delandtj/stm32-engraver/Hardware/graver-controller/output/pcb/mcu.png

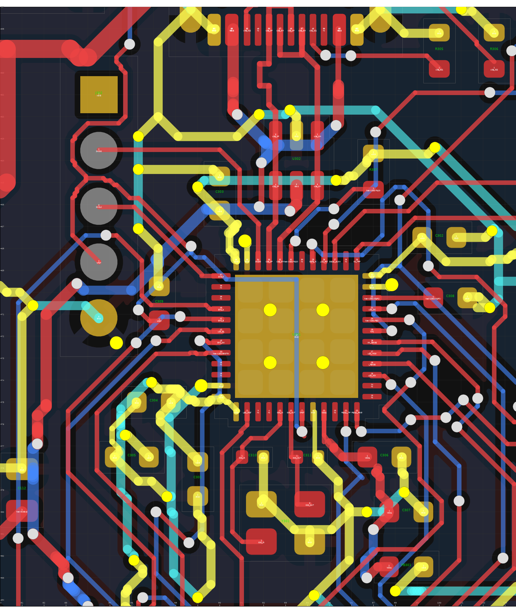
Hardware/graver-controller/output/pcb/mcu.png
