delandtj/stm32-engraver/docs/mosfet-module-eg27324-m3004d.jpg

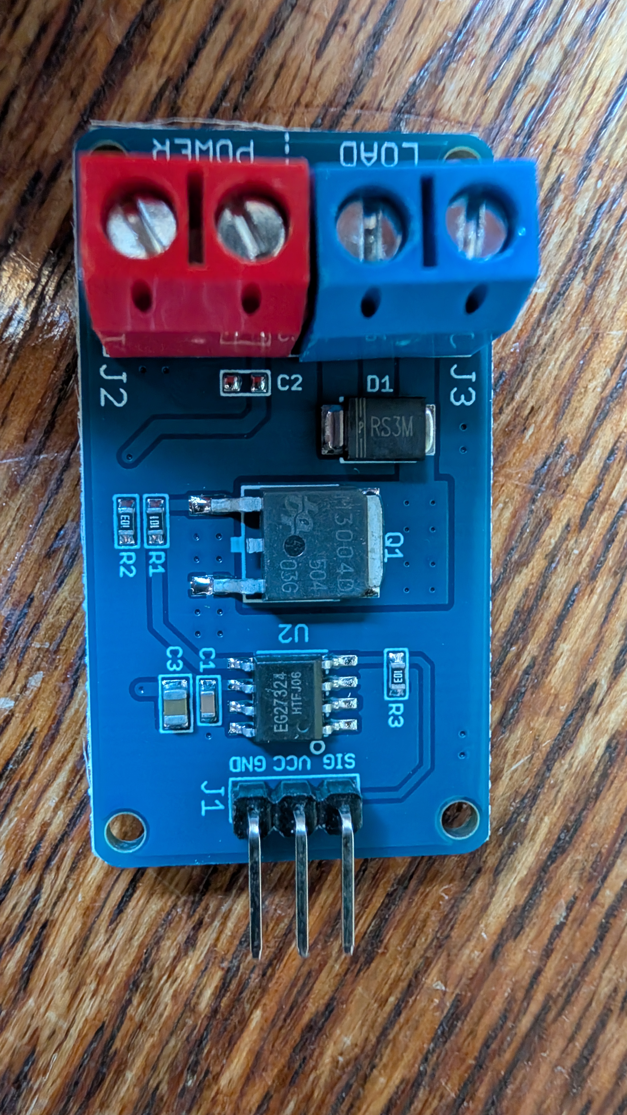
docs/mosfet-module-eg27324-m3004d.jpg
