delandtj/stm32-engraver/docs/HANDOFF.md

# Handoff: graver controller board

Last updated 2026-10-19. Read this first in a new session; it says what
exists, what is decided, how to work on it and what comes next.

## Start here

**Session 2026-10-16 .. 2026-10-19: first boards on the bench, rev 2, box.**

- Bring-up, board 1 (F101 bridged with a wire after it blew - no fuse, so
  bench PSU with a current limit only, never the brick):
  - Flashed over SWD (`probe-rs run --chip STM32F411CEUx`; with an ESP32
    also plugged in add `--probe 0483:3748`; `cargo run` needs
    `--bin graver-controller`).
  - Verified: display (offset 0, inverted), encoder (4 counts per detent),
    encoder push, settings journal, heartbeat LED D301 (~5 Hz).
  - The picture is now rotated 180 deg for the box mount (header end down).
  - Not yet done on any board: 24 V on VIN, VIN reading, pedal, NTC,
    firing, bootloader jump. See docs/bringup-checklist.md.
- F101 lesson: the rev 1 fuse (0437001.WR) is fast-acting, despite the old
  "1A slow" label. Hot-plugging 24 V into C101 blows it. Rev 1 rework: a
  1206 PTC, Littelfuse 1206L035/30WR (C2153989). Until then, ramp the PSU
  up from 0 V.
- Rev 1 hand soldering: the THT GND pads are solid to the In1 plane (no
  thermal relief) and hard to solder. Use a big chisel tip at 380-400 C
  lead-free, and preheat the board.
- Rev 1 as ordered is tag `rev1-ordered` (e8bf91c). `master` is rev 2:
  thermal relief on both inner planes (pcbkit now passes KRT
  `--thermal-relief` by default) and the TPS26602 input eFuse (ADR 0007).
  Fab set regenerated, DRC/parity 0.
- Enclosure: ADR 0006, `Box/`. A FreeCAD wedge (tray plus cover), the
  display sliding into rails with a snap latch, the encoder on two nuts,
  GX12-4 handpiece at the front, GX12-3 pedal at the rear, M3 heat-set
  inserts, support-free at 60 deg. Rebuild with `Box/build_enclosure.py`
  from the Params sheet. Still to measure: the real GX12 hole, nut and
  depth.
- Pedal socket: GX12-3 (never 4-pin), the pedal's own plug replaced.
- PC USB: if the ST-LINK vanishes, the xhci controller 0000:7b:00.0 may be
  wedged. Unbind and bind it via /sys/bus/pci/drivers/xhci_hcd.

Older notes follow.

**2026-10-09, ADR 0005 (Accepted): the board is now 4-layer, 85 x 60 mm,
built with pcbkit** on branch `adr-0005-compact-4layer`. kicad-cli DRC
after a zone refill: 0 errors, 0 unconnected, 0 parity, 0 warnings; USB
pair 0.25/0.15 with 0.000 mm skew and no vias; In1 solid GND, In2 solid
+3V3; a 25 x 20 mm reserve for the ADR 0004 boost stage at the front left.
Fab set in `Hardware/graver-controller/fab/`. Everything below this
paragraph that mentions `tools/pcb/`, 95 x 70 or 2 layers describes the
previous board (tag `pcb-pre-pcbkit`, also `v0.2`). The new pipeline is
`Hardware/graver-controller/tools/pcb5/` on `../pcbkit`:

    tools/pcb5/build.sh board    # netlist -> mkboard -> outline -> setrules -> place.py
    python3 tools/pcb5/handroute.py   # USB pair, crystal, QFN fan-out (group 'hand')
    tools/pcb5/build.sh route    # krt-route (about a minute), viaout, postroute.py
    python3 tools/pcb5/widen.py; python3 tools/pcb5/joins.py   # widths, the last opens
    python3 tools/pcb5/floors.py; pcbkit krt-reroute --keep LCD_SCK ENC_SW LCD_BL LCD_RST "Net-(R210-Pad1)" PEDAL_TIP   # ADR 0003 width floors
    tools/pcb5/build.sh finish   # gndpour, DRC, prune, silk, connlabels, refill
    tools/pcb5/build.sh check    # DRC + check.py (ADR 0005 acceptance) + renders
    tools/pcb5/build.sh fab      # jlcfab -> fab/, then cplcheck.py against EasyEDA

The committed .kicad_pcb is the artifact; the router is not deterministic,
so do not regenerate unless placement changes. joins.py holds explicit
coordinates for the five pairs KRT left open (NRST, VDDA, U102 input,
PEDAL_TIP, a GND island); after a re-route they may no longer apply.
Lessons: KRT cannot escape the QFN48 or attach to the USB-C pads by itself
(hence handroute.py), `krt-reroute` without `--keep` rips neighbours, and
every pcbnew save goes to scratch with only the .kicad_pcb copied back.
Open for order day: confirm the 4-layer price with the quote. The CPL
rotations are verified against the EasyEDA footprints (tools/pcb5/cplcheck.py,
27 of 27 parts agree), which is ADR 0003 step 8's rotation review. Width floors are ADR 0003's (0.5 / 0.3 mm), with 0.2 mm only at the
0.5 mm pitch pads as ADR 0003 says (ADR 0005 "As built").

**The board is finished and tagged `v0.2`** (commit 9645970, signed).
95 x 70 mm, 2-layer: 0 DRC errors, 0 schematic parity, 0 unconnected, all
eight per-net width floors PASS. Nothing more is needed on the copper.

**But it has never been near real hardware.** The firmware has never run on
a board, the 24 V punch test is unanswered and coil inductance is unmeasured.
v0.2 passes every check that can be run on a file; it is not a board known to
work. Keep that distinction - "0 DRC errors" is not "it works", and this
document said so too quietly once already.

**What changed on 2026-10-01 (ADR 0003 Decision 9):** every board connector
except USB-C became a row of plated holes for a soldered wire loom, the
rotary encoder moved off the board into the cover plate, and the board shrank
from 110 x 70 to 95 x 70. Jan's reasoning: sourcing the mating halves was the
problem, soldering is not. It also deleted the four unverified THT footprints
in one go, which was the largest open layout risk in the project, and brought
the long side under JLC's 100 x 100 price band.

**The single next piece of work** is the export set, ADR 0003 step 8 - Gerber,
drill, BOM, CPL, STEP, assembly PDF, test sheet. None of it exists; nothing in
`tools/` produces it. Everything else below is a decision rather than a task.

**Two decisions are blocking**, both in "Open items": whether JLC's THT service
still earns its fee, and a manufacturer STEP for J301 (without it the enclosure
cannot be drawn around the USB opening, because that part is invisible in 3D).
The pedal is settled (2026-10-13): a 5-pin TIG welding foot pedal, see
"Pedal" under Open items; one sample must be measured before ordering the batch.

## What this is

A new controller for the ITS-LZ-1335 solenoid graver in this repo. Batch of
8-10 boxes for a class (adults), each box = 24 V brick + this PCB + 1.3"
ST7789 display + one handpiece + TIG foot pedal. PCB fully assembled by
JLCPCB, no soldering by the builders, under EUR 150 per box, enclosure to be
3D printed (Creality K2 Max). Since 2026-10-01 Jan solders five wire looms
per box when he assembles them; the class still receives finished boxes.

Upstream project: Savage-Sabrina/DIY_SolenoidGraver (Arduino Nano board);
Jan's fork of it is a separate repo. Since 2026-09-17 this controller lives in
its own repository, github.com/delandtj/stm32-engraver (`origin`), split out
with full history. Branch `master`.

## Where things are

| What | Path |
|---|---|
| Spec / decisions (Accepted) | `docs/adr/0001-graver-controller-board.md` |
| KiCad 10 project | `Hardware/graver-controller/` (root + power/driver/mcu/io sheets) |
| PCB placement script (board is generated) | `Hardware/graver-controller/tools/pcb/` (see its README) |
| Schematic checks; retired generator | `Hardware/graver-controller/tools/` (see its README) |
| Rev 0.1 reference sheets (history) | `Hardware/graver-controller/tools/ref/` |
| Part choices, LCSC numbers, datasheet gotchas | `Hardware/graver-controller/docs/parts-power.md`, `parts-mcu.md` |
| Net-by-net capture list | `Hardware/graver-controller/docs/capture-netlist.md` |
| Firmware spec (Accepted) | `docs/adr/0002-firmware.md` |
| PCB layout + production spec (Accepted) | `docs/adr/0003-pcb-layout-and-production.md` |
| Firmware (Rust, embassy-stm32) | `Firmware/graver-controller/` (see its README) |
| Bench rig wiring | `docs/bench-rig.md` |
| Old Arduino design (context only) | `Schematic/`, `Arduino Code/`, `README.md` |

## State of the design

Schematic rev 0.1 is complete, drawn properly (wires, decoupling at pins,
signal flow), ERC 0 violations, every real part has value, footprint and LCSC
number. Since 2026-09-17 it is edited in eeschema (generator retired); U101
uses the HSOP-8 footprint without the library's 0.2 mm thermal vias.

2026-10-01 schematic edits (ADR 0003 Decision 9), ERC 0 and netlist diffed
pad-by-pad against the previous export - every difference was an auto-
generated net *name* following its anchor pin, no connectivity changed:

| ref | was | is now |
|---|---|---|
| J101 | `Connector:Barrel_Jack_Switch` | `Conn_01x02`, pads GND / +24V |
| J201 | Screw terminal symbol, Phoenix footprint | same symbol, `PinHeader_1x04` |
| J401 | `Conn_01x07`, JST XH footprint | same symbol, `PinHeader_1x07` |
| J402 | `Connector_Audio:AudioJack3_SwitchTR` | `Conn_01x04`, pads T / RN / R / S |
| J403 | was `SW401`, `RotaryEncoder_Switch_MP` | `Conn_01x04`, pads A / GND / B / SW |

The five pad rows carry **no LCSC and no MPN property**. They are holes, not
parts; an empty field is dropped when place.py copies fields onto footprints,
which then reads as a schematic-parity mismatch, so the properties are gone
from the symbols rather than blanked. Three orphaned no-connect flags (the
old jack's switch pole, the jack's TN pin, the encoder's MP lugs) were
removed with them.

PCB: re-placed, re-routed and **electrically complete** on 95 x 70 mm as of
2026-10-01. State: **0 DRC errors, 0 schematic parity, 0 unconnected, 11
warnings** (1 lib_footprint_mismatch on J301, 4 track_dangling, 6
via_dangling), 126 router vias plus 10 hand vias, all placement checks and
ADR criteria PASS, all eight per-net width floors PASS, GND island and
sense-ground trees PASS, one allowed USB crossing and no disallowed ones.

The autorouter left 3 pairs open and they were closed by hand with
`tools/pcb/close_open.py` (see below), then captured into
`tools/pcb/manual.json` with `place.py --export-manual`: 38 items, 33 on
+5V and 5 on GND.

Drill table, counted off the board 2026-10-01 (needed for the ADR 0003
step 8 export, and worth a glance before ordering):

| drill | count | what |
|---|---|---|
| 0.30 mm | 233 | vias |
| 0.60 mm | 4 | J301 shell tabs |
| 1.00 mm | 24 | the four pad rows (19) + J302 SWD (5) |
| 1.20 mm | 2 | C101 bulk cap |
| 1.75 mm | 2 | J101 power in |
| 0.65 mm NPTH | 2 | J301 locating pegs |
| 3.20 mm NPTH | 4 | M3 mounting holes |

271 holes, 5 plated sizes, 2 non-plated. Ordinary for a 2-layer board with
a stitched pour - no slots, no castellations, no half-holes, and JLC does
not surcharge for the number of distinct sizes. Two notes:

- **0.30 mm is exactly JLC's minimum for standard plated holes**, so the
  vias sit on the floor with no margin. That is deliberate (ADR 0003
  Decision 5: "via 0.3 mm drill / 0.6 mm pad, no smaller via anywhere"),
  but it is the first thing that would bite if their cheap tier moved.
  0.4 mm drill would buy margin at the cost of fatter pads.
- **J101 is 1.75 mm, not 1.4.** Its footprint is named
  `SolderWire-1sqmm_1x02_P5.4mm_D1.4mm_OD2.7mm` and the `D1.4mm` is the
  wire it suits, not the hole; the file says `(drill 1.75)`. The ADR, the
  parts table and this document all repeated the 1.4 mm misreading until
  2026-10-01. Nothing on the board changed - 1.75 mm is roomier for an
  18 AWG lead and the annular ring is still 0.48 mm.

`graver-controller.kicad_pcb` is GENERATED by the pipeline in `Hardware/graver-controller/tools/pcb/` (README there is the
manual):

    python3 tools/pcb/place.py --copper --silk --route   # ~45 min, --route is the slow part
    python3 tools/pcb/place.py --copper --silk           # ~1 min, no autorouting
    tools/pcb/render.sh                                  # PNGs in output/pcb/
    tools/pcb/routability.sh                             # placement test on a scratch copy

- place.py: board from the netlist (117 parts linked by UUID, parity 0),
  outline, placement as data tables, courtyard / keepout / ADR-distance
  checks with a PASS/FAIL table.
- copper.py: the critical copper, scripted and locked: GND pour and
  stitching, M3 and crystal keepouts, QFN escape fan, decoupling, crystal,
  VDDA, USB pair (37.9/37.9 mm, skew 0, bands on B.Cu), VIN and flyback
  loop at 1.0 mm, buck loops, shunt Kelvin, sense-side ground as one tie
  (checked tree), GATE_IN, I_SENSE, VIN_SENSE, +3V3 and +5V trunks. Prints
  a budgets table.
- silk.py: references off the pads, rear-edge labels, pin-1 marks.
- autoroute.py: KiCadRoutingTools on a SCRATCH COPY, strict, three
  attempts, best imported into the group 'autorouted' after kicad-cli
  grading against the committed .kicad_pro. The router is not
  deterministic: the same input gives 4-17 open pairs between runs.
- manual.py: `place.py --export-manual` keeps tracks drawn by hand in
  pcbnew across regeneration (tools/pcb/manual.json).

### Closing the last pairs: close_open.py (2026-10-01)

`tools/pcb/close_pairs.py` is **stale and must not be trusted**. It is not a
general pair-closer: it was written against the old board's geometry and names
specific tracks and corridors ("the +3V3 B.Cu track at (41.55, 47.8)",
"ENC_A's run across the corridor is the wall between PB2's escape and R303").
On the 95 x 70 board those do not exist and a `--dry` run ends in
`FAIL: nothing ripped for ENC_A`.

`tools/pcb/close_open.py` replaces it for this board. It is a thin driver over
the GOOD half of close_pairs - the two-layer clearance grid, the Dijkstra, the
octilinear simplifier, the `manual` grouping - with targets found by name or
by point instead of by coordinate table:

    python3 tools/pcb/close_open.py          # draw, refill, save, DRC
    python3 tools/pcb/close_open.py --dry    # report only, write nothing

It closed all three: +5V D105.1 -> C201.1 (68.28 mm, 10 vias, 0.30 mm) and
two short GND stubs. Three things learned doing it, all now enforced in the
script:

1. **The USB pair walls the board in half.** With the pair's B.Cu shadow
   respected there is NO +5V path between the power block and the gate
   driver. A search allowed to ignore the shadow came back crossing the run
   TWICE at a shallow angle, and `autoroute.usb_reference_check` refused it -
   correctly. The answer is the same one the old board used: ONE short
   perpendicular crossing at a site chosen for clearance (1.56 mm of B.Cu at
   90 degrees, 0.60 mm off the nearest pair track), whitelisted in
   `autoroute.USB_CROSSING_OK`. That entry moved from the old board's
   (36.45, 21.35) to **(31.62, 16.77)**.
2. **The script must draw ALL targets every run.** `group_manual` replaces
   the whole `manual` group with whatever the current run drew, so a run that
   skipped a target as "already joined" deleted the copper that joined it -
   two runs in a row ping-pong between the +5V route and the GND stubs. Hence
   `strip_manual()`: start from the autorouted baseline each time and redraw
   everything. The script owns that group.
3. **A bridge or hand route on a Power-class net must carry that net's
   `.kicad_dru` floor**, not `W_SIG`. See the copper.py note - one undersized
   segment makes autoroute's import gate refuse the entire route.

The router remains nondeterministic (3-10 open pairs between runs), so the
committed board file is still the artifact: do not regenerate unless
placement or scripted copper changes. If you do regenerate, `manual.py`
restores the 38 hand-drawn items from manual.json, and anything still open
after that is `close_open.py`'s job again.

The old warning that the mop-up re-lays 0.3 mm nets at 0.2 mm is stale -
`autoroute.py` now runs one pass per width class at that class's floor and
the import gate drops any net carrying undersized copper. All eight floors
PASS on the committed board.

The old "right third of the board is empty" complaint is what the shrink to
95 x 70 answered: the connectors and the encoder were reserving that space,
not the electronics, which fit inside 84.5 x 64.0 mm. Design rules and net
classes live in the .kicad_pro (SaveBoard rewrites it, the scripts restore
it).

3D: only J301 (HRO USB-C) still lacks a model in any KiCad library, and it
needs a manufacturer STEP in a project 3d/ folder before the enclosure
export. SW401 and J402 left this list with the parts themselves; the cover
plate now carries the encoder and the box sockets, so the enclosure model
needs their geometry instead, plus a loom exit for each pad row.

Pad rows all read left to right in ascending pad order, pad 1 leftmost seen
from the front - the old "J201 is rotated 180, so it reverses" rule is gone.
J201: 1 VIN, 2 COIL_NEG, 3 NTC, 4 GND.

Key facts (details in the ADR):

- Coil: both 1335s measure 141 ohm = the 24 V / ~4 W variant. So: 24 V brick
  standard, electronics rated 18-36 V, DC jack rated 30 V (bricks 18-30 V).
  Coil current 0.17-0.26 A; driver scoped to coils >= ~100 ohm.
- MCU: STM32F411CEU6 on board (same chip as the WeAct Blackpill, used for
  firmware bring-up). USB-C for DFU updates, SWD header for development,
  PA10 pull-up so the ROM bootloader picks USB. No LSE crystal.
- Strike: TIM1 one-pulse on PA8 -> UCC27517 gate driver -> IRLR3410 low
  side. 1 ohm shunt -> TLV9062: one half is a x11 amplifier to PA6, the
  other a comparator (~0.77 A trip) into TIM1_BKIN (PB12).
- Flyback: SS110 + SMBJ24A fast decay by default; SI2309 P-FET across the
  TVS gives plain-diode slow decay when PB14 (DECAY_SLOW) is high.
- Power: fuse, DMP6023LE reverse-polarity P-FET, SMBJ36A, 470 uF, LM5164
  buck set to 5.28 V (EN starts ~14 V, BST cap 2.2 nF), two SS14 OR the buck
  and USB VBUS into +5V, AP2112K-3.3 LDO. USB alone runs the logic.
- UI: 1.3" ST7789 240x240 3.3 V module (no CS, SPI mode 3, backlight PWM
  from PB6 through 100 R). It sits in the cover plate on a 7-way loom
  soldered into the J401 pad row: 1 GND, 2 +3V3, 3 SCL, 4 SDA, 5 RES, 6 DC,
  7 BLK, pad 1 leftmost. The encoder (30 detents / 15 pulses, TIM3 encoder
  mode, push on PB7) also mounts in the cover plate and takes 4 wires into
  J403: 1 ENC_A, 2 GND, 3 ENC_B, 4 ENC_SW. The EC11's encoder common and
  switch common are the same net, so they join at the encoder body - run 5
  wires if that bridge is unwanted. The 10k pull-ups R402-R404 and the 10 nF
  debounce C401-C403 stay on the board at the MCU, so the A/B lines leave the
  board at 10k impedance: keep that loom away from the handpiece cable, and
  if it miscounts on the bench drop R402-R404 to 2.2k. Any EC11 now works -
  it is off the JLC BOM, so no footprint has to match it.
- Pedal: no jack on the board. J402 is a 4-pad row - 1 TIP, 2 RN, 3 RING,
  4 SLV - and the socket lives in the box. The circuit is unchanged: ring =
  3V3 through 1k, tip = wiper to PA1, ring sense on PA2, PESD5V0S2BT on tip
  and ring. RN (pad 2) is GND and only matters for a TRS socket with a
  ring-normal contact. The chosen 5-pin TIG pedal does not use it - see
  "Pedal" under Open items for the wiring.
- Handpiece: 4-pin GX12 aviation socket on the box (pre-wired pigtail), its
  four wires soldered into the J201 pad row: 1 VIN, 2 COIL_NEG, 3 NTC
  (optional), 4 GND, pad 1 leftmost. The 5.08 mm terminal and screw plug are
  gone.
- Power in: J101, two 1.75 mm holes, pad 1 GND and pad 2 +24V, brick leads
  soldered straight in. With no barrel jack the DC-005's 30 V ceiling no
  longer applies, so the 18-36 V electronics rating is the only limit left.
  The pair wants a strain-relief anchor so the solder is not the mechanical
  joint.
  Input protection differs per revision. Rev 1 (the 12 built boards): F101
  fuse + Q101 reverse-polarity PMOS; F101 gets the 1206L035/30WR PTC as a
  rework (see "Brick sizing"). Rev 2 (branch board-rev2, ADR 0007): U103
  TPS26602 eFuse instead of F101/Q101/D101/R101 - reverse polarity, 1.0 A
  limit with auto-retry, 42 ms soft start, UVLO 14.9 V, 38 V clamp. Its RTN
  net is a separate copper island and must never be tied to GND. Layout:
  tools/pcb5/efuse.py.
- Pin map: in the ADR, verified against the datasheet.

### Brick sizing (worked out 2026-10-01)

**Buy 24 V, 2 A (48 W).** The box needs far less than that; the headroom is
for sag, not for amps.

| load at 24 V | current |
|---|---|
| coil while the FET is on, 141 ohm (ADR 0001) | 170 mA |
| logic, realistic: MCU + display + backlight | ~35 mA |
| logic, the buck's full design budget (0.5 A at 5 V, ~90%) | ~115 mA |
| **worst-case peak, coil and logic together** | **~290 mA** |
| average at the 35 % duty cap | ~95 mA |

About 7 W worst case, and the coil only draws its 170 mA during the pulse.
The on-board fuse is the board's own ceiling: since 2026-10-17 a 1206 PTC
(Littelfuse 1206L035/30WR, 0.35 A hold, 0.75 A trip). The first 12 boards
were built with 0437001.WR, which is a FAST 1 A fuse despite the old "1A
slow" label, and it blows when 24 V is hot-plugged into the 470 uF (board 1
did). Swap F101 for the PTC on those boards; until then ramp the PSU up
from 0 V instead of connecting a live supply.

1 A (24 W) would genuinely do it with 3x margin. 2 A costs about the same and
buys three things:

1. Headroom for the low-resistance-coil experiment (a 36 ohm coil on 24 V
   pulls 0.67 A - see the 12 V note below).
2. Inrush into the 470 uF bulk cap at power-on without the brick hiccuping.
3. **No sag during the strike**, which is the one that affects how it feels.

Point 3 is the real reason. A weak brick droops under the pulse, and droop
weakens the hit directly: less voltage across the coil means slower current
rise, which IS the strike. The firmware is watching too - it warns below
18 V (VIN_WARN_MV) and refuses to fire below 15 V (VIN_MIN_FIRE_MV) - so a
weedy supply would both soften the strikes and nag on screen. The 470 uF cap
buffers the fast edge but cannot carry a long pulse: at 170 mA for 15 ms it
would sag 5.4 V on its own, so the brick supplies the bulk of a long strike.
Stiffness counts more than raw amps.

Two limits:

- **Do not exceed 36 V.** That is the electronics rating, and it is now the
  only one - the old 30 V ceiling belonged to the DC jack, which is gone.
- **A bigger brick does not make it hit harder.** Coil resistance sets the
  current: 24 V into 141 ohm is 170 mA whether the supply can do 1 A or 10 A.
  Extra capacity only stops it sagging. The levers for more punch are higher
  voltage or a lower-resistance coil, not a bigger brick.

### 12 V coils: what it would take (worked out 2026-10-01, nothing changed)

Two different questions, often confused. Neither has been acted on.

**(a) Running the BOARD from a 12 V brick.** Three blockers, one of them
hardware:

1. The buck never starts. The LM5164 EN/UVLO divider is 1M / 120k against a
   1.5 V threshold, so it enables at about 14 V. At 12 V there is no 5 V
   rail and the board is dead except on USB. Fix: R106 120k -> ~180k, which
   moves the threshold to ~10 V. One 0402.
2. `VIN_MIN_FIRE_MV = 15_000` refuses to fire. Note the firmware ALREADY has
   `#[cfg(feature = "low-vin")]` setting it to 10_000, written for a 12 V
   bench supply and marked "Never for the production board". The mechanism
   exists; it needs promoting to a supported mode. `VIN_WARN_MV = 18_000`
   needs rethinking with it.
3. The I_SENSE readout saturates. The x11 amp (R210 10k / R211 1k) hits the
   rail at 0.3 A. Fix: R210 -> 6.8k. The overcurrent trip is unaffected - it
   reads the raw shunt.

Nothing else cares: fuse, DMP6023LE (60 V), SMBJ36A, 470 uF 63 V, the LM5164
itself (100 V, works from 6 V), IRLR3410 (100 V), UCC27517 (fed from 5 V),
the LDO. All overrated at 24 V and absurdly so at 12 V.

**Supporting EITHER supply is the same work, not more.** Set the enable
threshold once at ~10 V and both bricks start the buck; set the sense gain
once at ~x8 and both coil currents fit. The firmware already has the piece
that makes it work - supply compensation holds volt-seconds constant
(`t = t * V_NOMINAL_MV / vin`, V_NOMINAL_MV = 24_000), so at 12 V it doubles
the on-time for the same strength setting. Cost: two resistor values plus
making two constants runtime instead of compile-time. The only compromise is
that at 12 V the doubled on-time hits T_ON_MAX and the duty cap sooner, so
the top of the strength range compresses.

**(b) Driving a 12 V COIL from the existing 24 V brick.** Electrically fine,
but the board was deliberately scoped against it. A 12 V coil of the same
~4 W is ~36 ohm, so on 24 V it pulls 0.67 A, and parts-power.md already
analysed this exact case: it collides with the 0.8 A trip (0.67 A is 84 % of
threshold - expect nuisance trips on a comparator whose ~3 mV hysteresis is
a known weakness), the 1 ohm 1206 shunt (0.45 W while on against a 0.25 W
rating; 0.16 W average at 35 % duty), and the I_SENSE ceiling. That document
offers the fix if low-R coils are ever wanted: "a 0.33 ohm 1 W 2512 shunt
with gain about 30, a 2 A slow fuse, and a trip threshold that scales with
the coil". ADR 0001's "coils >= ~100 ohm" scope is that sentence being
declined.

Coil thermals are the real limit there, not the board: 24 V into 36 ohm is
16 W while on, against a ~4 W part, with nothing but duty cycle protecting
it. At the 35 % cap that averages 5.6 W, over rating - it would want the cap
nearer 25 % and the NTC fitted so the 70 C cutout can see the coil.

**Why it is still interesting**: deliberately overdriving a solenoid is
standard practice and good for punch - more volts across less inductance
makes current rise faster, and rise rate IS the strike. It is the cheapest
way to find out what harder drive feels like without building a boost rail.

**But do not spend this margin yet.** ADR 0001's biggest open question is
whether 24 V has enough punch in the first place, and that bench test has
not been run. Going lower before answering it spends headroom that may turn
out to be needed. Also note coil inductance is still unmeasured (open item
2), and until it is, neither force nor heating is predictable for any of
this - L/R decides whether a 3 ms pulse reaches 0.1 A or 0.65 A.

## State of the firmware

Written 2026-09-16, builds clean (release, clippy) for thumbv7em-none-eabihf,
NOT yet run on hardware. Tasks: analog (ADC 200 Hz), input (TIM3 encoder or
three buttons with `--features buttons`), control (modes, menu, safety),
strike (TIM1 one-pulse on PA8, break on PB12 latches), ui (ST7789 via
mipidsi, 10 Hz partial refresh), main (IWDG fed only while control
heartbeats). Settings journal in flash sector 7. Hold the encoder push at
power-up = ROM DFU bootloader. `--features bench` fires a fixed burst at
boot for scoping the strike path.

    cd Firmware/graver-controller
    cargo build --release [--features buttons,bench]
    cargo run --release            # probe-rs + defmt, needs an SWD probe
    tools/dfu.sh                   # USB DFU, no probe

Verified on hardware (board 1, F101 bridged, 2026-10-19): ST7789 with offset 0 and
colours inverted, as in ui.rs; encoder at 4 counts per detent (the class
encoders rest with A and B open at every click; firmware 9eb05f2); settings
journal survives a power cycle. Still unverified: the bootloader jump (DFU
by holding the encoder push at power-up).

## How to work on the schematic

The generator is RETIRED (ADR 0003, 2026-09-17). Edit the .kicad_sch sheets
in eeschema; `tools/build.py` refuses to run because it would overwrite them.

    cd Hardware/graver-controller
    tools/verify.sh                 # must print "Found 0 violations"; PNGs in output/verify/

- Keep the rev 0.1 drawing discipline by hand: wires not labels within a
  block, decoupling at the pins, signal flow left to right.
- Every part keeps value, footprint, LCSC and MPN fields; the JLC BOM is
  exported from them.
- Small field edits (footprint, LCSC) can be made in the file while
  eeschema is closed; verify afterwards.
- Rendering: the kicad MCP's sch_render_png is broken on this machine; use
  `kicad-cli sch export svg` + `rsvg-convert` (verify.sh does this).
- Commits are GPG-signed with a desktop pinentry; they fail when Jan is
  away from the keyboard. Commit while he is present, or unsigned only
  when he says so (2026-09-18 evening's commits are unsigned on his
  instruction). Never `git add -A`.
- Plain ASCII in files. No Claude attribution lines in commits.

## Open items (carry into the next session)

Hardware verification before layout is frozen:

1. Bench test with a 24 V brick: is 24-30 V enough punch? If not, the
   ADR's boost-rail alternative comes back. The OPEN-SMART module Jan has
   tops out at 13.5 V, so use a D4184-class module or the real FET for this.
2. Measure coil inductance (LCR meter or current-rise on a scope). Sizes the
   TVS energy and confirms the 0.5-15 ms pulse range.
3. Part number printed on the solenoids (confirms 24 V variant and duty).
4. OT3499 display: check the real pinout (7-pin, GND VCC SCL SDA RES DC
   BLK expected) and whether BLK idles high on the module.
5. VOID since 2026-10-01. This was the list of THT connector footprints to
   measure against loose parts before layout froze - DC-005 jack, WJ2EDGRC
   terminal drill, NMJ6HCD2 normalling contacts, encoder lug spacing. Every
   one of those parts left the board with ADR 0003 Decision 9, and their
   replacements are stock KiCad pad rows whose only dimension is a drill
   size. Nothing to buy, nothing to measure, no re-spin risk from this.
6. Known, accepted limits: I_SENSE saturates above ~0.3 A (trip uses the
   raw shunt), VIN_SENSE saturates during a surge clamp, comparator
   hysteresis is only ~3 mV, a shorted FET is not caught (coil just runs
   warm at 0.2 A).

Decisions still open (ADR "Open Questions"):

- **Pedal (decided 2026-10-13, one sample to measure before the batch).** A
  bought 5-pin TIG welding foot pedal (e.g. "Vector Welding remote control
  pedal, 1.5 m cable, 5 pin"): a pot plus a microswitch that closes early
  in the travel, spring return, steel housing. Spring return is the reason
  over an expression pedal, which stays where it was left. The 2+3 pin
  variant has the same five wires on two plugs; avoid it. No board change -
  the ordered board serves it as is. The box carries a GX12-3 socket at the
  rear (decided 2026-10-19, ADR 0006): the pedal's own plug is cut off and a
  GX12-3 plug fitted. Never GX12-4 - that would mate with the handpiece
  socket and put 24 V on the pedal input. Wired to J402:

  | Pedal wire | J402 pad |
  |---|---|
  | pot wiper | 1 TIP |
  | pot top, through the pedal's microswitch | 3 RING (3V3 via 1k) |
  | pot bottom | 4 SLV (GND) |
  | - | 2 RN: leave unwired (GND, TRS normal contact only) |

  Plus ~100k from TIP to SLV at the box socket. The switch in series with
  the pot top is a hardware interlock: foot off, the pot is unpowered and
  the wiper reads 0 V whatever the pot does. Unplugged, the 100k pulls TIP
  to 0 V, so the box reads heel-down and cannot fire. Cost: ring sense always
  reads "pedal present", so the display cannot tell unplugged from foot-off
  (the ADR 0001 section 8 detection is given up; fail-safe either way).
  Measure on the first sample before buying the rest: pot value (5k-50k is
  fine; 10k is typical), pinout (not standardised between brands), smooth
  sweep, and that the switch closes near the start of the travel.
- **A manufacturer STEP for J301 (new, 2026-10-01, blocks the enclosure).**
  KiCad 10 ships no 3D model anywhere for the HRO TYPE-C-31-M-12 and nothing
  in the library is the right shape to stand in, so the part is invisible in
  the 3D view, in `kicad-cli pcb render` and in a STEP export. The board is
  fine - it is populated, in the BOM and in the CPL - but you cannot cut an
  accurate opening in the printed rear wall from a model that does not
  contain the connector. Drop a vendor STEP into a project `3d/` folder.
  Same loose part answers the other USB-C unknown: its mouth direction
  against the real thing.
- **Keep JLC's THT assembly service? (new, 2026-10-01)** After the rework the
  parts needing it are C101 and J302; wire pads are holes with no part. Note
  J301 is not pure SMD either - the HRO TYPE-C-31-M-12 is 16 SMD pads + 4
  PLATED shell tabs + 2 NPTH pegs - so there is through-hole solder on the
  board regardless. It is a standard JLC SMT line item in practice; confirm
  how they bill it at order time. Options: keep the service (default, no
  change), move C101 to an SMD 470 uF and go SMT-only (needs a stock and
  ripple check), or hand-fit C101 on 12 boards (breaks the ADR 0001
  reproducibility rule for a tall electrolytic).
- NTC fitted on all handpieces, or rely on the coil-resistance estimate?
- Default strike ranges (1-60 Hz, 0.5-15 ms, 35 % duty cap) to be confirmed
  on the bench.

## Next steps, in order

Updated 2026-10-19. The previous list (review, export set, JLC order,
bench-rig bring-up, enclosure) is done or superseded; see git history.

1. **Bring-up, continued** (docs/bringup-checklist.md): 24 V on VIN from the
   bench PSU (board 1 has no fuse - current limit 200 mA, max ~500 mA when
   firing), VIN reading against the PSU, pedal, NTC, then firing into the
   handpiece. Decide the open R407 pedal safety finding (remove R407 per
   board, or ~4.7k TIP-SLV at the socket) before trusting the pedal.
2. **Power input: DC-005 jack.** J101 is two wire holes (pad 1 GND, pad 2
   +24V). Prepare for a DC-005 female 5.5 x 2.1 mm barrel jack instead. Decide
   between a panel-mount jack in the box rear wall wired into J101 (no board
   change; the Box cable entry and tie post become a jack hole) and a
   PCB-mount jack on the rear edge (rev 2 board change). Mind the history:
   ADR 0003 Decision 9 dropped the DC-005 and with it a 30 V ceiling. The
   brick is 24 V, so 30 V is fine, but check the jack's current rating
   (>= 2 A) and which pin is centre-positive.
3. **Firmware, Frequency mode: strength drops as frequency rises - discuss
   before changing.** In Frequency mode the pedal sets the frequency and the
   knob sets the strength (t_on). `limit_t_on` in src/control.rs clamps
   t_on to `duty_cap_pct / f` (35 % by default). At 20 Hz the cap is 17.5 ms
   (above T_ON_MAX 15 ms), but at 60 Hz it is 5.8 ms, so pressing the pedal
   further cuts the energy per hit. Jan's expectation is the other way
   round. The options to discuss: keep the energy per hit and limit the
   frequency instead, raise or scale the duty cap, or show on screen when the
   cap is active. The cap protects the coil thermally (ADR 0001/0002), so
   any change has to keep that.
4. **Box**: measure the real GX12 socket (hole, nut AF, depth) and update
   the Params sheet. Print the tray first, then the cover; check the display
   latch and the encoder two-nut fit on the print.
5. **Rev 1 rework for the class boxes**: the PTC in F101 on every built
   board, before any of them sees a brick.
6. **Rev 2 order** when the above settles: the fab set on `master` is
   current (TPS26602 is a JLC extended part, about USD 2.3).
