delandtj/stm32-engraver/Box/preview-cover-underside.png

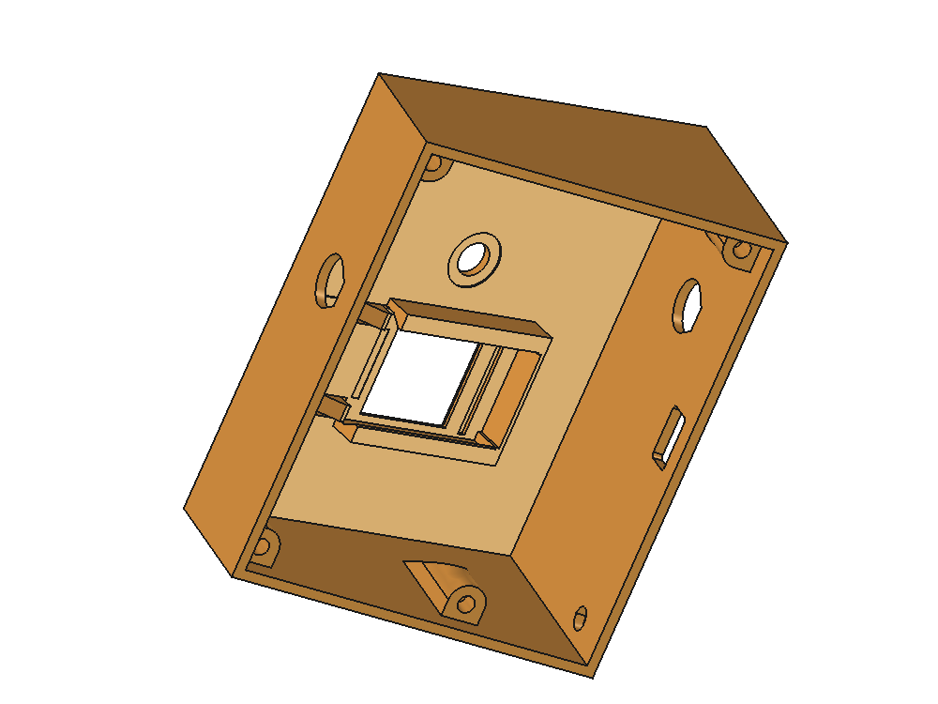
Box/preview-cover-underside.png
