delandtj/stm32-engraver/Hardware/graver-controller/output/pcb/board.png

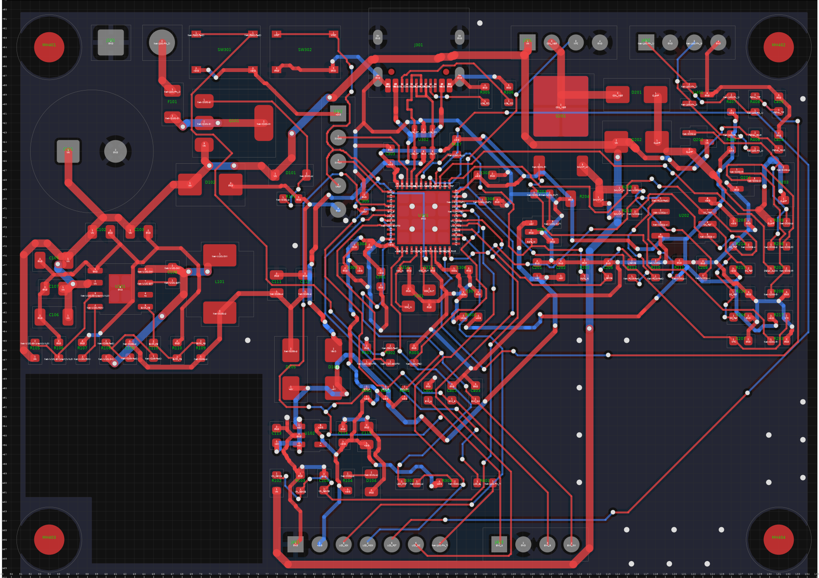
Hardware/graver-controller/output/pcb/board.png
