delandtj/stm32-engraver/Hardware/graver-controller/output/pcb/driver.png

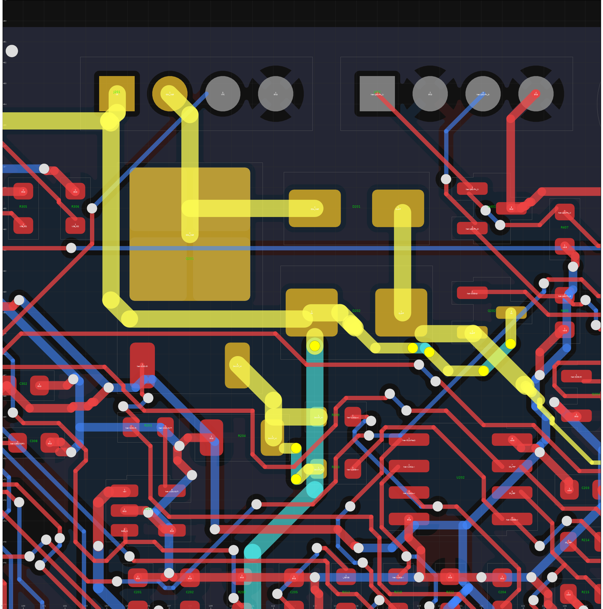
Hardware/graver-controller/output/pcb/driver.png
