delandtj/stm32-engraver/Hardware/graver-controller/output/pcb/placement.png

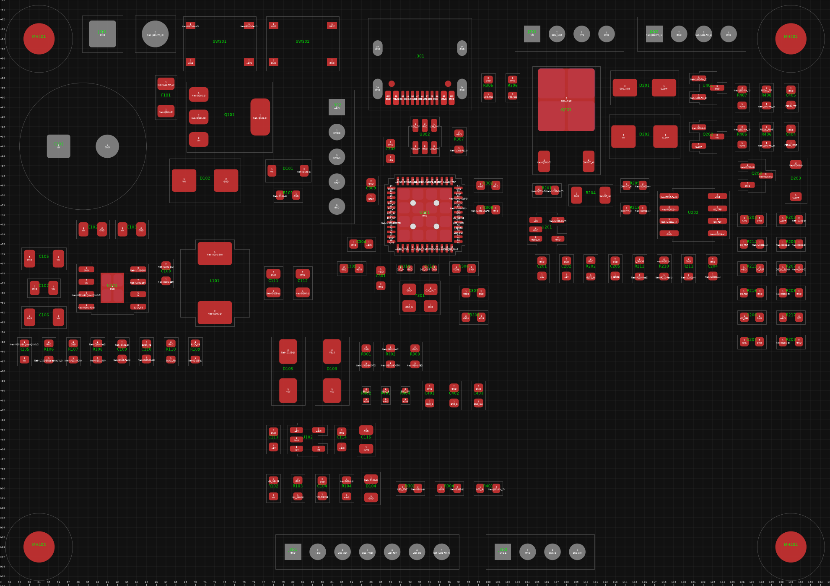
Hardware/graver-controller/output/pcb/placement.png
