delandtj/stm32-engraver/Hardware/graver-controller/output/pcb/power.png

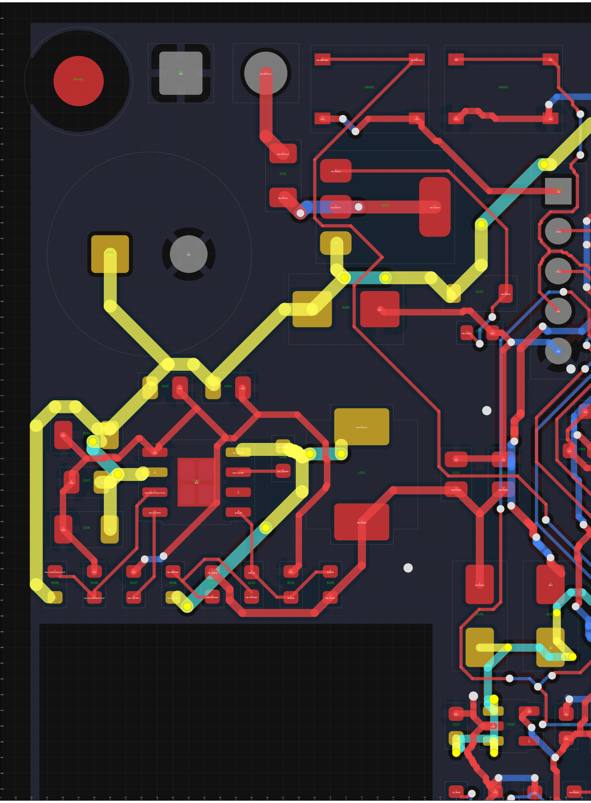
Hardware/graver-controller/output/pcb/power.png
