delandtj/stm32-engraver/Hardware/graver-controller/output/pcb/usb.png

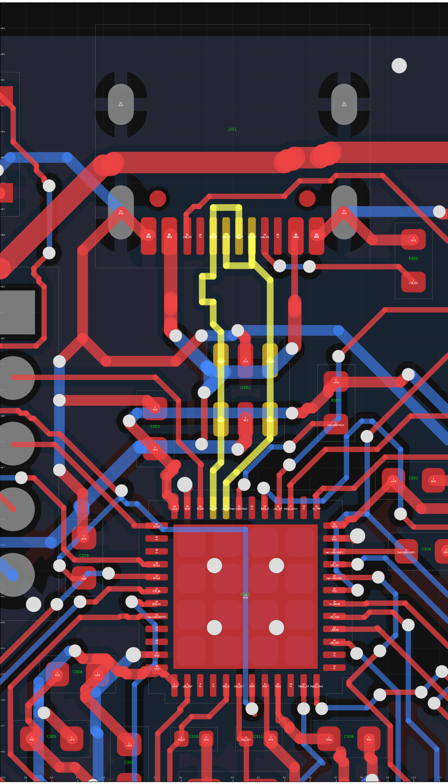
Hardware/graver-controller/output/pcb/usb.png
