delandtj/stm32-engraver/Hardware/graver-controller/fab/graver-controller-bom.csv

Comment | Designator | Footprint | LCSC Part #
470uF 63V | C101 | CP_Radial_D12.5mm_P5.00mm | C2940725
1uF 100V | C102 | C_0805_2012Metric | C5370002
100nF 100V | C103,C107 | C_0805_2012Metric | C28233
100nF | C104,C202,C203,C206,C207,C301,C302,C303,C304,C309 | C_0603_1608Metric | C14663
2.2uF 100V | C105,C106 | C_1206_3216Metric | C170101
2.2nF 50V | C108 | C_0603_1608Metric | C1604
3.3nF | C109 | C_0603_1608Metric | C1613
100pF C0G | C110 | C_0603_1608Metric | C14858
22uF 25V | C111,C112 | C_0805_2012Metric | C45783
1uF | C113,C114,C201,C306 | C_0603_1608Metric | C15849
10uF | C115 | C_0805_2012Metric | C15850
1nF | C204 | C_0603_1608Metric | C1588
10nF | C205,C307,C401,C402,C403,C404,C405 | C_0603_1608Metric | C57112
4.7uF | C305,C308 | C_0603_1608Metric | C19666
12pF C0G | C310,C311 | C_0402_1005Metric | C1547
BZT52C12 | D101,D203 | D_SOD-123 | C19077410
SMBJ36A | D102 | D_SMB | C19077588
SS14 | D103,D105 | D_SMA | C2480
PWR green | D104 | LED_0805_2012Metric | C2297
SS110 | D201 | D_SMA | C18199178
SMBJ24A | D202 | D_SMB | C19077578
STAT red | D301 | LED_0603_1608Metric | C2286
1A slow | F101 | Fuse_1206_3216Metric | C99537
600R@100MHz | FB301 | L_0603_1608Metric | C1002
USB-C | J301 | USB_C_Receptacle_HRO_TYPE-C-31-M-12 | C165948
SWD | J302 | PinHeader_1x05_P2.54mm_Vertical | C492404
33uH | L101 | L_Changjiang_FXL0630 | C177245
DMP6023LE | Q101 | SOT-223-3_TabPin2 | C154901
IRLR3410 | Q201 | TO-252-2 | C3017
SI2309CDS | Q202 | SOT-23 | C10493
BSS123 | Q203 | SOT-23 | C427379
0603WAF1003T5E | R101,R102,R110,R202,R203,R205,R208,R407 | R_0603_1608Metric | C25803
8.2k | R103 | R_0603_1608Metric | C25981
2.2k | R104 | R_0603_1608Metric | C4190
1M | R105,R214 | R_0603_1608Metric | C22935
120k | R106 | R_0603_1608Metric | C25808
0603WAF3302T5E | R107,R215 | R_0603_1608Metric | C4216
150k | R108 | R_0603_1608Metric | C22807
340k 1% | R109 | R_0603_1608Metric | C2933203
10R | R201 | R_0603_1608Metric | C22859
1R 1% | R204 | R_1206_3216Metric | C2907374
22k | R206 | R_0603_1608Metric | C31850
100R | R207,R401 | R_0603_1608Metric | C22775
1k | R209,R211,R213,R302,R304,R405,R406,R408 | R_0603_1608Metric | C21190
10k | R210,R216,R217,R301,R303,R307 | R_0603_1608Metric | C25804
330R | R212 | R_0603_1608Metric | C23138
5.1k | R305,R306 | R_0603_1608Metric | C23186
10k | R402,R403,R404 | R_0402_1005Metric | C25744
TS-1187A-B-A-B | SW301,SW302 | SW_Push_1P1T_XKB_TS-1187A | C318884
LM5164DDAR | U101 | HSOP-8-1EP_3.9x4.9mm_P1.27mm_EP2.41x3.1mm | C477928
AP2112K-3.3 | U102 | SOT-23-5 | C51118
UCC27517DBVR | U201 | SOT-23-5 | C99395
TLV9062IDR | U202 | SOIC-8_3.9x4.9mm_P1.27mm | C398355
STM32F411CEU6 | U301 | QFN-48-1EP_7x7mm_P0.5mm_EP5.6x5.6mm | C60420
USBLC6-2SC6 | U302 | SOT-23-6 | C7519
PESD5V0S2BT | U401 | SOT-23 | C49338
25MHz 10pF | Y301 | Crystal_SMD_3225-4Pin_3.2x2.5mm | C70582
