delandtj/stm32-engraver/Box/cover.step

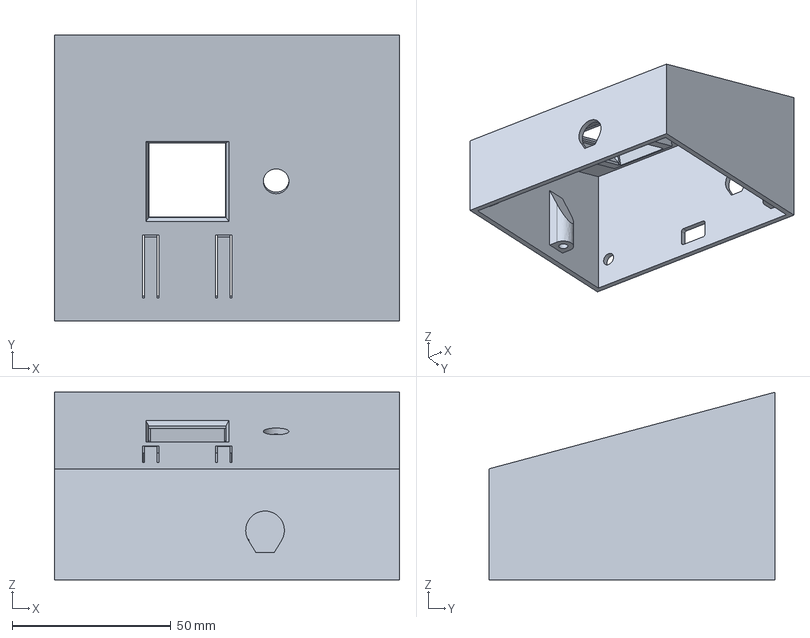
[picture p9: CAD file, 2026-10-19]
Box/cover.step
108.8 x 90.3 x 59.2 mm
