delandtj/stm32-engraver/Box/tray.step

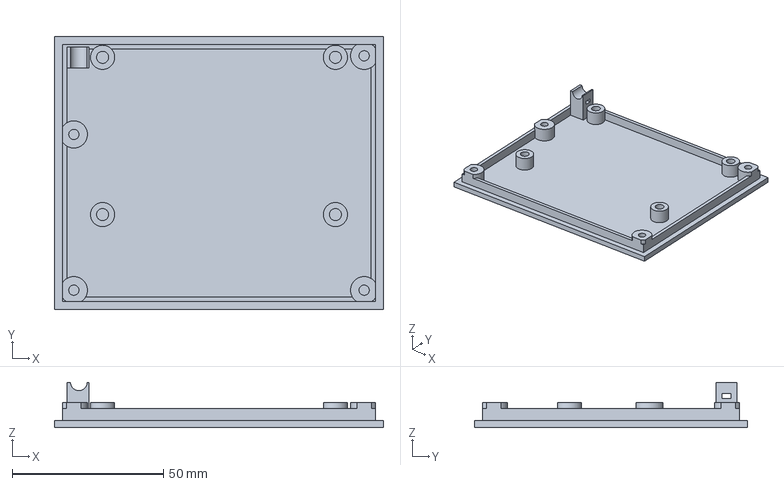
[picture p10: CAD file, 2026-10-19]
Box/tray.step
108.8 x 90.3 x 15.0 mm
