delandtj/stm32-engraver/Box/enclosure.FCStd

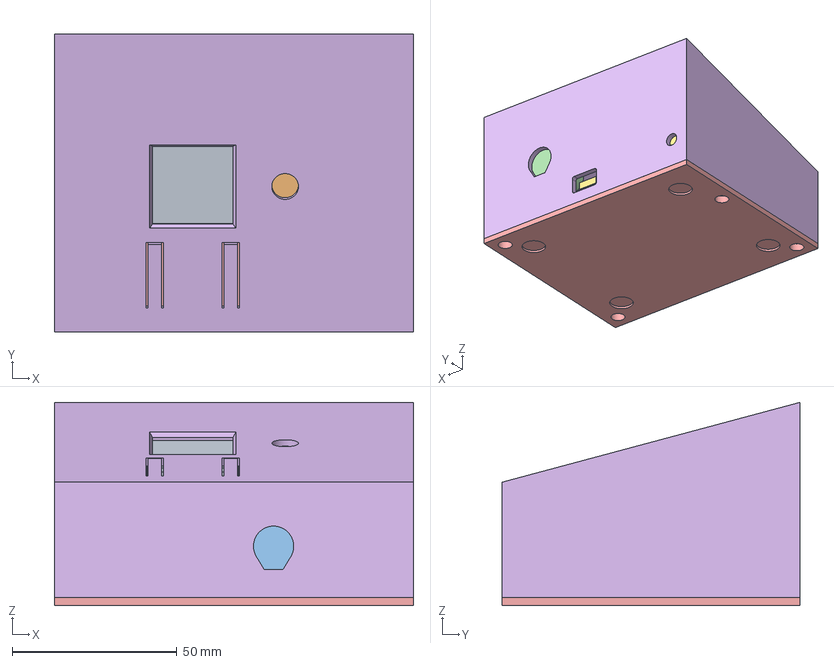
[picture p11: CAD file, 2026-10-19]
Box/enclosure.FCStd
108.8 x 90.3 x 61.6 mm
DisplayModule
EncoderKeepout
GX12Keepout
PedalKeepout
Tray
Cover
PCB
