delandtj/stm32-engraver/(list of files, cad)

Other CAD files:
Box/cover.stl
Box/tray.stl
