delandtj/stm32-engraver/Box/preview-assembly.png

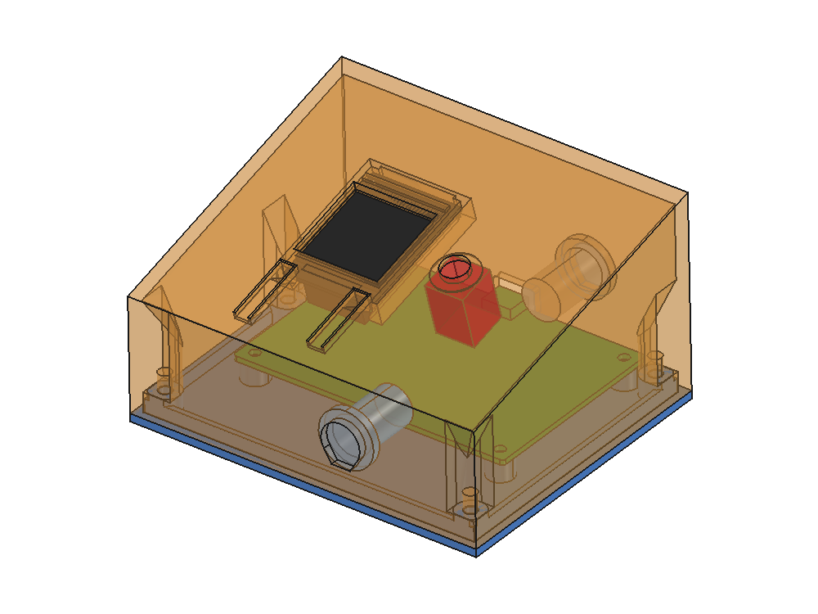
Box/preview-assembly.png
