delandtj/stm32-engraver/Hardware/graver-controller/graver-controller.kicad_pcb

## KiCad design Hardware/graver-controller/graver-controller.kicad_pcb (2026-10-18)

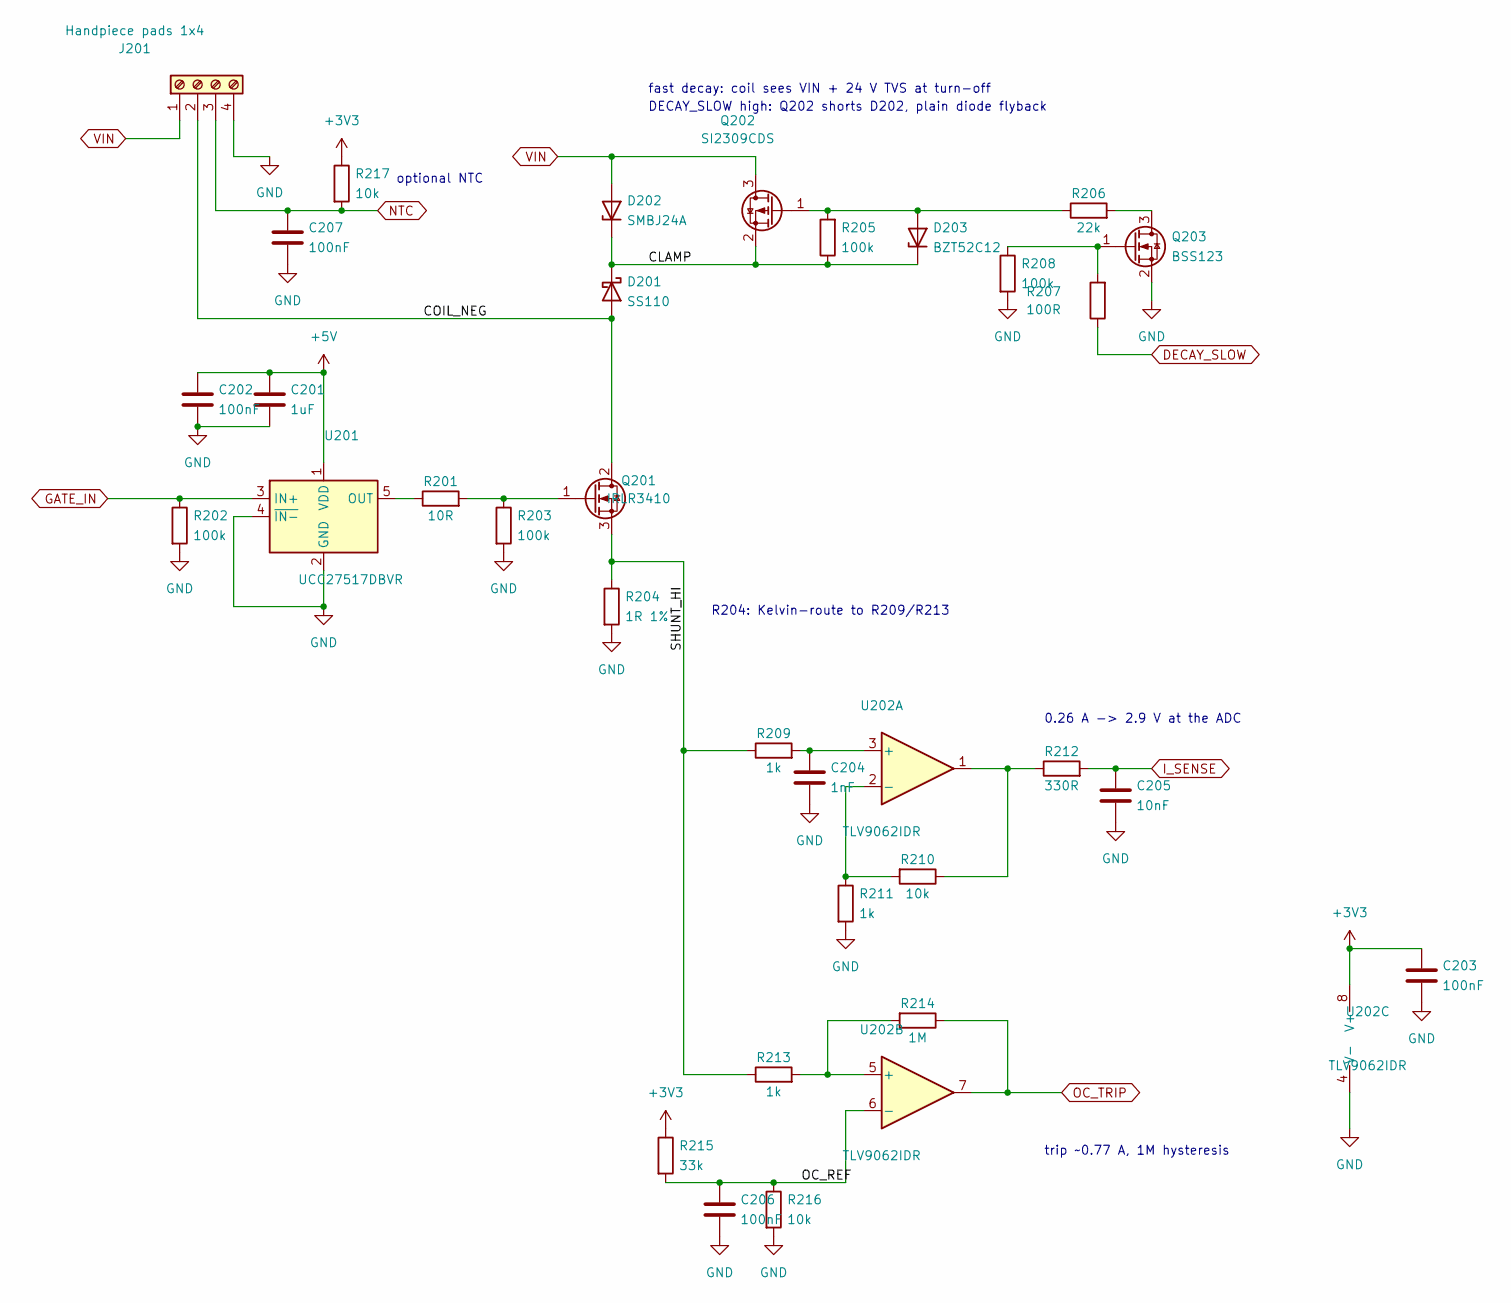
[picture p13: schematic driver.kicad_sch]

Parts:
C201: 1uF; C_0603_1608Metric; MPN CL10A105KB8NNNC; LCSC C15849
C202, C203, C206, C207: 100nF; C_0603_1608Metric; MPN CC0603KRX7R9BB104; LCSC C14663
C204: 1nF; C_0603_1608Metric; MPN CL10B102KB8NNNC; LCSC C1588
C205: 10nF; C_0603_1608Metric; MPN CL10B103KB8NNNC; LCSC C57112
D201: SS110; D_SMA; MPN SS110; LCSC C18199178
D202: SMBJ24A; D_SMB; MPN SMBJ24A; LCSC C19077578
D203: BZT52C12; D_SOD-123; MPN BZT52C12; LCSC C19077410
J201: Handpiece pads 1x4; PinHeader_1x04_P2.54mm_Vertical
Q201: IRLR3410; TO-252-2; MPN IRLR3410TRPBF; LCSC C3017
Q202: SI2309CDS; SOT-23; MPN SI2309CDS-T1-GE3; LCSC C10493
Q203: BSS123; SOT-23; MPN BSS123; LCSC C427379
R201: 10R; R_0603_1608Metric; MPN 0603WAF100JT5E; LCSC C22859
R202, R203, R205, R208: 100k; R_0603_1608Metric; MPN 0603WAF1003T5E; LCSC C25803
R204: 1R 1%; R_1206_3216Metric; MPN FRC1206F1R00TS; LCSC C2907374
R206: 22k; R_0603_1608Metric; MPN 0603WAF2202T5E; LCSC C31850
R207: 100R; R_0603_1608Metric; MPN 0603WAF1000T5E; LCSC C22775
R209, R211, R213: 1k; R_0603_1608Metric; MPN 0603WAF1001T5E; LCSC C21190
R210, R216, R217: 10k; R_0603_1608Metric; MPN 0603WAF1002T5E; LCSC C25804
R212: 330R; R_0603_1608Metric; MPN 0603WAF3300T5E; LCSC C23138
R214: 1M; R_0603_1608Metric; MPN 0603WAF1004T5E; LCSC C22935
R215: 33k; R_0603_1608Metric; MPN 0603WAF3302T5E; LCSC C4216
U201: UCC27517DBVR; SOT-23-5; MPN UCC27517DBVR; LCSC C99395
U202: TLV9062IDR; SOIC-8_3.9x4.9mm_P1.27mm; MPN TLV9062IDR; LCSC C398355

Connections:
+3V3: C203.1, R215.1, R217.1, U202.8 (V+); also elsewhere on the board
/Driver/CLAMP: D201.1 (K), D202.1 (K), D203.1 (K), Q202.2 (S), R205.1
/Driver/COIL_NEG: D201.2 (A), J201.2, Q201.2 (D)
/Driver/OC_REF: C206.1, R215.2, R216.1, U202.6 (-)
/Driver/SHUNT_HI: Q201.3 (S), R204.1, R209.1, R213.1
DECAY_SLOW: R207.1; also elsewhere on the board
GATE_IN: R202.1, U201.3 (IN+); also elsewhere on the board
I_SENSE: C205.1, R212.2; also elsewhere on the board
NTC: C207.1, J201.3, R217.2; also elsewhere on the board
unnamed: D203.2 (A), Q202.1 (G), R205.2, R206.1
unnamed: Q201.1 (G), R201.2, R203.1
unnamed: Q203.3 (D), R206.2
unnamed: Q203.1 (G), R207.2, R208.1
unnamed: R210.1, R212.1, U202.1
unnamed: R201.1, U201.5 (OUT)
unnamed: C204.1, R209.2, U202.3 (+)
unnamed: R210.2, R211.1, U202.2 (-)
unnamed: R213.2, R214.2, U202.5 (+)
OC_TRIP: R214.1, U202.7; also elsewhere on the board

Notes on the sheet:
optional NTC
trip ~0.77 A, 1M hysteresis
R204: Kelvin-route to R209/R213
fast decay: coil sees VIN + 24 V TVS at turn-off
0.26 A -> 2.9 V at the ADC
DECAY_SLOW high: Q202 shorts D202, plain diode flyback

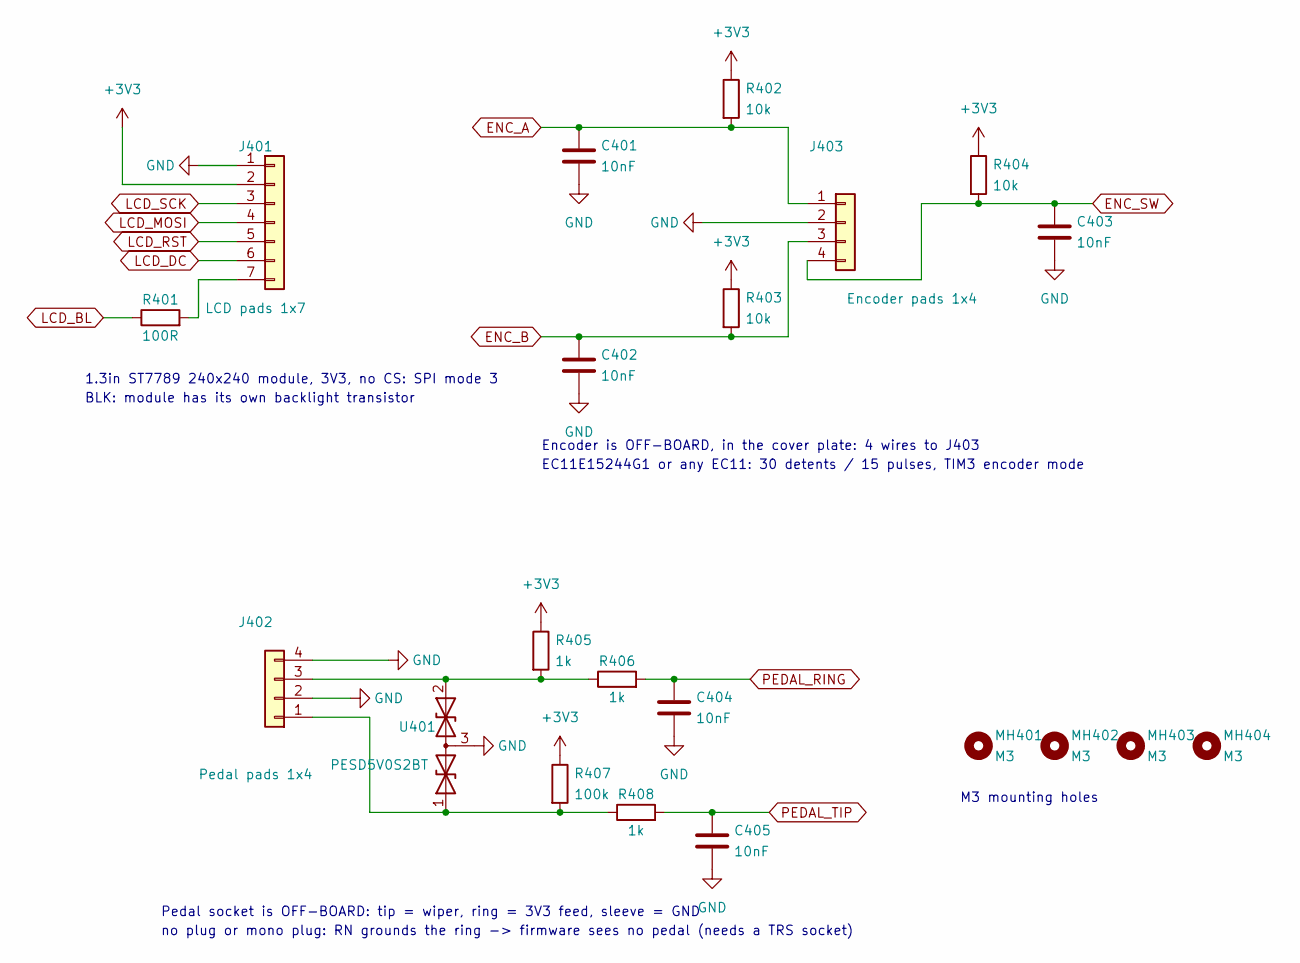
[picture p14: schematic io.kicad_sch]

Parts:
C401, C402, C403, C404, C405: 10nF; C_0603_1608Metric; MPN 0603B103K500NT; LCSC C57112
J401: LCD pads 1x7; PinHeader_1x07_P2.54mm_Vertical
J402: Pedal pads 1x4; PinHeader_1x04_P2.54mm_Vertical
J403: Encoder pads 1x4; PinHeader_1x04_P2.54mm_Vertical
MH401, MH402, MH403, MH404: M3; MountingHole_3.2mm_M3
R401: 100R; R_0603_1608Metric; MPN 0603WAF1000T5E; LCSC C22775
R402, R403, R404: 10k; R_0402_1005Metric; MPN 0402WGF1002TCE; LCSC C25744
R405, R406, R408: 1k; R_0603_1608Metric; MPN 0603WAF1001T5E; LCSC C21190
R407: 100k; R_0603_1608Metric; MPN 0603WAF1003T5E; LCSC C25803
U401: PESD5V0S2BT; SOT-23; MPN PESD5V0S2BT,215; LCSC C49338

Connections:
+3V3: J401.2, R402.1, R403.1, R404.1, R405.1, R407.1; also elsewhere on the board
ENC_A: C401.1, J403.1, R402.2; also elsewhere on the board
ENC_B: C402.1, J403.3, R403.2; also elsewhere on the board
ENC_SW: C403.1, J403.4, R404.2; also elsewhere on the board
LCD_BL: R401.1; also elsewhere on the board
LCD_DC: J401.6; also elsewhere on the board
LCD_MOSI: J401.4; also elsewhere on the board
LCD_RST: J401.5; also elsewhere on the board
LCD_SCK: J401.3; also elsewhere on the board
unnamed: J401.7, R401.2
unnamed: J402.1, R407.2, R408.1, U401.1 (A1)
unnamed: J402.3, R405.2, R406.1, U401.2 (A2)
PEDAL_RING: C404.1, R406.2; also elsewhere on the board
PEDAL_TIP: C405.1, R408.2; also elsewhere on the board

Notes on the sheet:
no plug or mono plug: RN grounds the ring -> firmware sees no pedal (needs a TRS socket)
Encoder is OFF-BOARD, in the cover plate: 4 wires to J403
EC11E15244G1 or any EC11: 30 detents / 15 pulses, TIM3 encoder mode
1.3in ST7789 240x240 module, 3V3, no CS: SPI mode 3
BLK: module has its own backlight transistor
M3 mounting holes
Pedal socket is OFF-BOARD: tip = wiper, ring = 3V3 feed, sleeve = GND

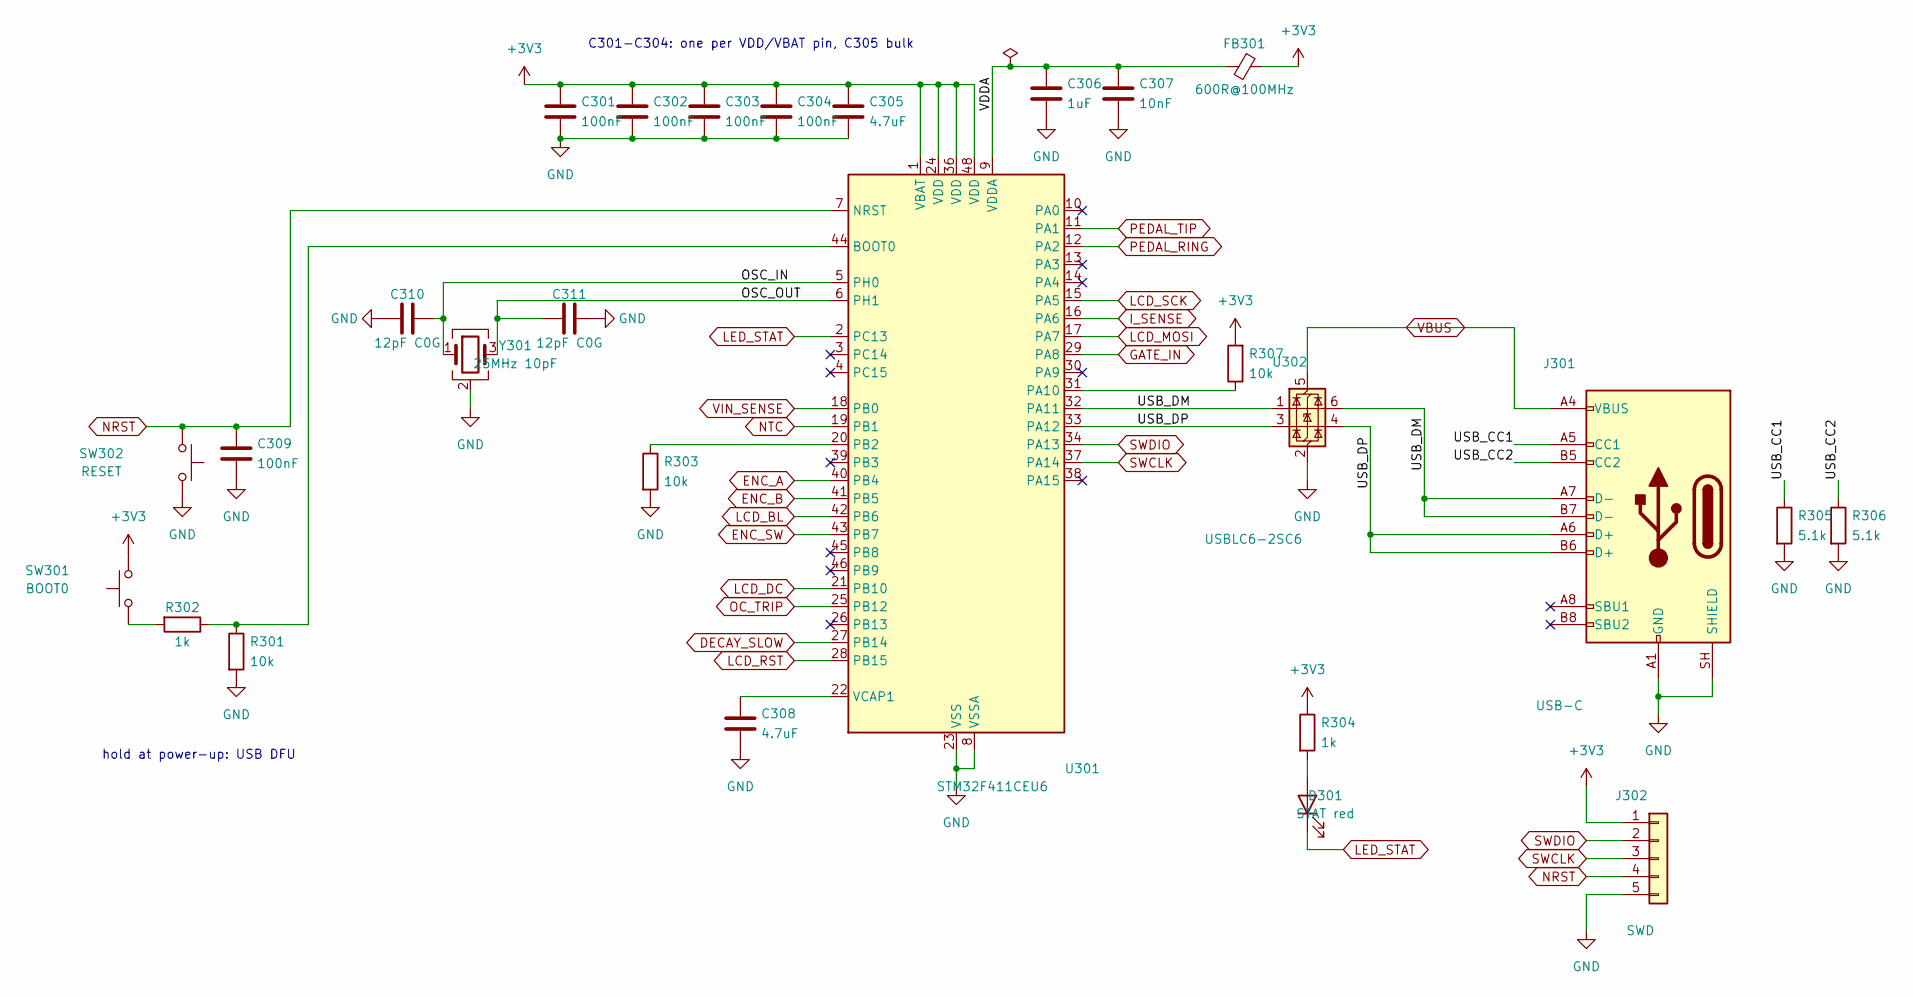
[picture p15: schematic mcu.kicad_sch]

Parts:
C301, C302, C303, C304, C309: 100nF; C_0603_1608Metric; MPN CC0603KRX7R9BB104; LCSC C14663
C305, C308: 4.7uF; C_0603_1608Metric; MPN CL10A475KO8NNNC; LCSC C19666
C306: 1uF; C_0603_1608Metric; MPN CL10A105KB8NNNC; LCSC C15849
C307: 10nF; C_0603_1608Metric; MPN 0603B103K500NT; LCSC C57112
C310, C311: 12pF C0G; C_0402_1005Metric; MPN 0402CG120J500NT; LCSC C1547
D301: STAT red; LED_0603_1608Metric; MPN KT-0603R; LCSC C2286
FB301: 600R@100MHz; L_0603_1608Metric; MPN GZ1608D601TF; LCSC C1002
J301: USB-C; USB_C_Receptacle_HRO_TYPE-C-31-M-12; MPN TYPE-C-31-M-12; LCSC C165948
J302: SWD; PinHeader_1x05_P2.54mm_Vertical; MPN PZ254V-11-05P; LCSC C492404
R301, R303, R307: 10k; R_0603_1608Metric; MPN 0603WAF1002T5E; LCSC C25804
R302, R304: 1k; R_0603_1608Metric; MPN 0603WAF1001T5E; LCSC C21190
R305, R306: 5.1k; R_0603_1608Metric; MPN 0603WAF5101T5E; LCSC C23186
SW301: BOOT0; SW_Push_1P1T_XKB_TS-1187A; MPN TS-1187A-B-A-B; LCSC C318884
SW302: RESET; SW_Push_1P1T_XKB_TS-1187A; MPN TS-1187A-B-A-B; LCSC C318884
U301: STM32F411CEU6; QFN-48-1EP_7x7mm_P0.5mm_EP5.6x5.6mm; MPN STM32F411CEU6; LCSC C60420
U302: USBLC6-2SC6; SOT-23-6; MPN USBLC6-2SC6; LCSC C7519
Y301: 25MHz 10pF; Crystal_SMD_3225-4Pin_3.2x2.5mm; MPN X322525MMB4SI; LCSC C70582

Connections:
+3V3: C301.1, C302.1, C303.1, C304.1, C305.1, FB301.1, J302.1, R304.1, R307.2, SW301.2, U301.1 (VBAT), U301.24 (VDD), U301.36 (VDD), U301.48 (VDD); also elsewhere on the board
/MCU/OSC_IN: C310.1, U301.5 (PH0), Y301.1
/MCU/OSC_OUT: C311.1, U301.6 (PH1), Y301.3
/MCU/USB_CC1: J301.A5 (CC1), R305.1
/MCU/USB_CC2: J301.B5 (CC2), R306.1
/MCU/USB_DM: J301.A7 (D-), J301.B7 (D-), U301.32 (PA11), U302.1 (I/O1), U302.6 (I/O1)
/MCU/USB_DP: J301.A6 (D+), J301.B6 (D+), U301.33 (PA12), U302.3 (I/O2), U302.4 (I/O2)
/MCU/VDDA: C306.1, C307.1, FB301.2, U301.9 (VDDA)
DECAY_SLOW: U301.27 (PB14); also elsewhere on the board
ENC_A: U301.40 (PB4); also elsewhere on the board
ENC_B: U301.41 (PB5); also elsewhere on the board
ENC_SW: U301.43 (PB7); also elsewhere on the board
GATE_IN: U301.29 (PA8); also elsewhere on the board
I_SENSE: U301.16 (PA6); also elsewhere on the board
LCD_BL: U301.42 (PB6); also elsewhere on the board
LCD_DC: U301.21 (PB10); also elsewhere on the board
LCD_MOSI: U301.17 (PA7); also elsewhere on the board
LCD_RST: U301.28 (PB15); also elsewhere on the board
LCD_SCK: U301.15 (PA5); also elsewhere on the board
LED_STAT: D301.1 (K), U301.2 (PC13)
NRST: C309.1, J302.4, SW302.1, U301.7 (NRST)
NTC: U301.19 (PB1); also elsewhere on the board
unnamed: D301.2 (A), R304.2
unnamed: R302.2, SW301.1
unnamed: R301.1, R302.1, U301.44 (BOOT0)
unnamed: R307.1, U301.31 (PA10)
unnamed: R303.1, U301.20 (PB2)
unnamed: C308.1, U301.22 (VCAP1)
OC_TRIP: U301.25 (PB12); also elsewhere on the board
PEDAL_RING: U301.12 (PA2); also elsewhere on the board
PEDAL_TIP: U301.11 (PA1); also elsewhere on the board
SWCLK: J302.3, U301.37 (PA14)
SWDIO: J302.2, U301.34 (PA13)
VBUS: J301.A4 (VBUS), J301.A9 (VBUS), J301.B4 (VBUS), J301.B9 (VBUS), U302.5 (VBUS); also elsewhere on the board
VIN_SENSE: U301.18 (PB0); also elsewhere on the board

Notes on the sheet:
hold at power-up: USB DFU
C301-C304: one per VDD/VBAT pin, C305 bulk

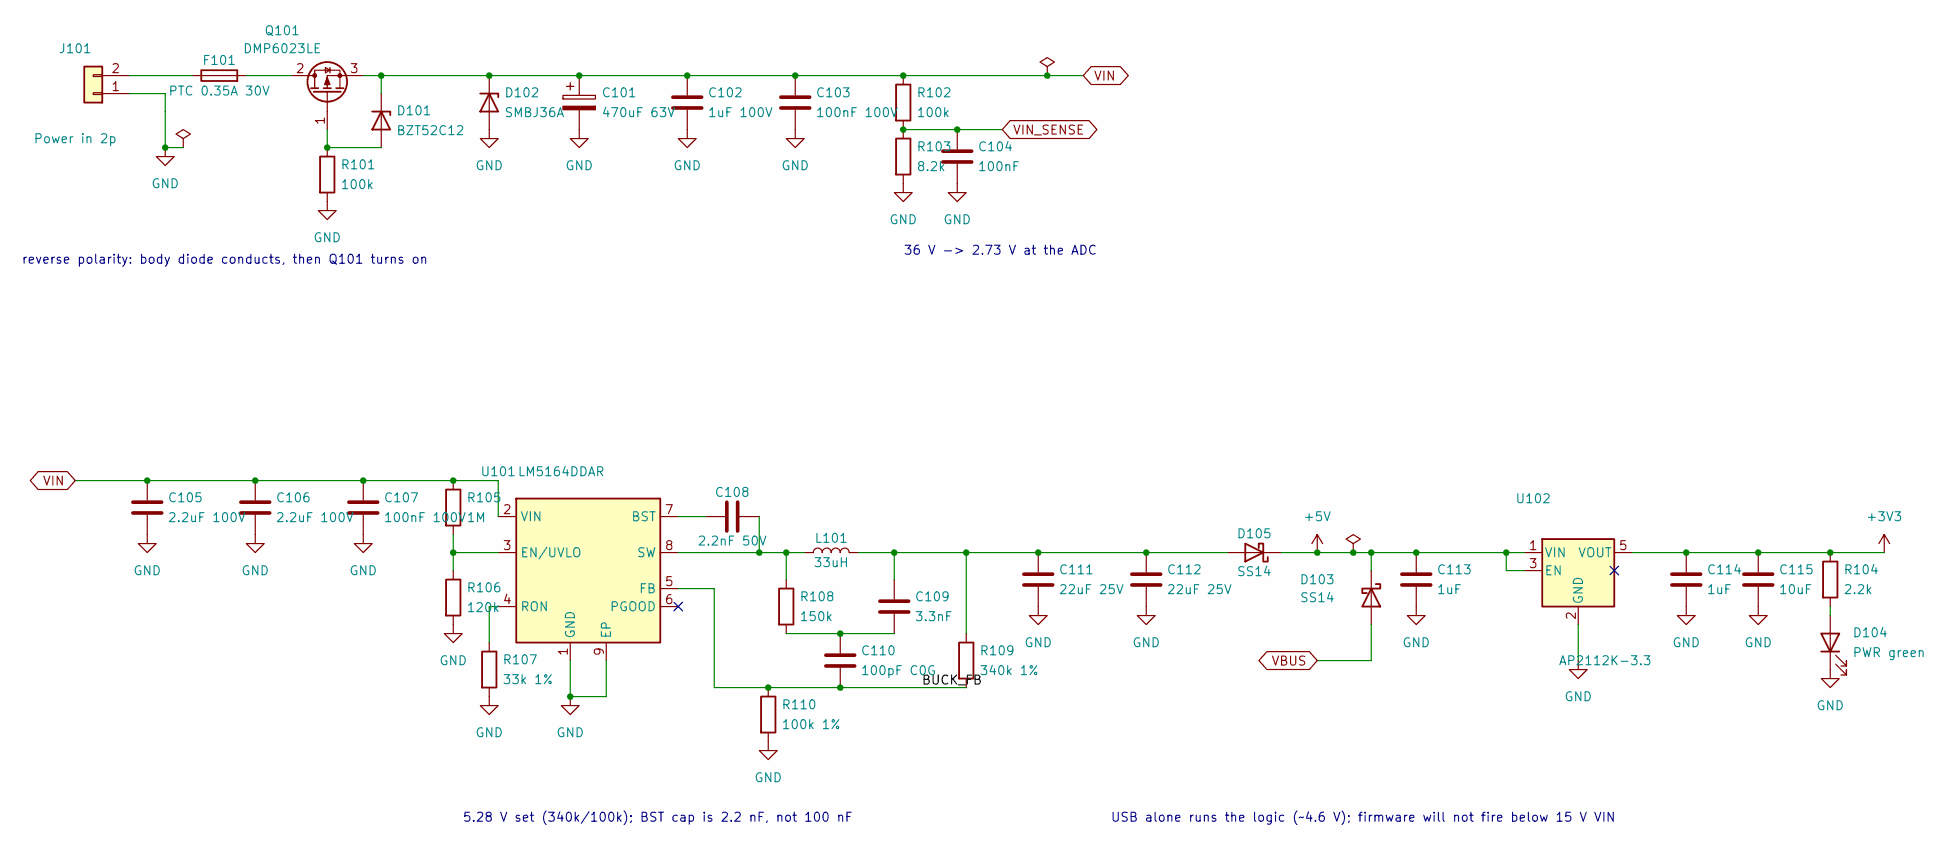
[picture p16: schematic power.kicad_sch]

Parts:
C101: 470uF 63V; CP_Radial_D12.5mm_P5.00mm; MPN 63ZLJ470M12.5X20; LCSC C2940725
C102: 1uF 100V; C_0805_2012Metric; MPN CC0805KKX7R0BB105; LCSC C5370002
C103, C107: 100nF 100V; C_0805_2012Metric; MPN CL21B104KCFNNNE; LCSC C28233
C104: 100nF; C_0603_1608Metric; MPN CC0603KRX7R9BB104; LCSC C14663
C105, C106: 2.2uF 100V; C_1206_3216Metric; MPN CL31B225KCHSNNE; LCSC C170101
C108: 2.2nF 50V; C_0603_1608Metric; MPN CL10B222KB8NNNC; LCSC C1604
C109: 3.3nF; C_0603_1608Metric; MPN CL10B332KB8NNNC; LCSC C1613
C110: 100pF C0G; C_0603_1608Metric; MPN CL10C101JB8NNNC; LCSC C14858
C111, C112: 22uF 25V; C_0805_2012Metric; MPN CL21A226MAQNNNE; LCSC C45783
C113, C114: 1uF; C_0603_1608Metric; MPN CL10A105KB8NNNC; LCSC C15849
C115: 10uF; C_0805_2012Metric; MPN CL21A106KAYNNNE; LCSC C15850
D101: BZT52C12; D_SOD-123; MPN BZT52C12; LCSC C19077410
D102: SMBJ36A; D_SMB; MPN SMBJ36A; LCSC C19077588
D103, D105: SS14; D_SMA; MPN SS14; LCSC C2480
D104: PWR green; LED_0805_2012Metric; MPN KT-0805G; LCSC C2297
F101: PTC 0.35A 30V; Fuse_1206_3216Metric; MPN 1206L035/30WR; LCSC C2153989
J101: Power in 2p; SolderWire-1sqmm_1x02_P5.4mm_D1.4mm_OD2.7mm
L101: 33uH; L_Changjiang_FXL0630; MPN FXL0630-330-M; LCSC C177245
Q101: DMP6023LE; SOT-223-3_TabPin2; MPN DMP6023LE-13; LCSC C154901
R101, R102: 100k; R_0603_1608Metric; MPN 0603WAF1003T5E; LCSC C25803
R103: 8.2k; R_0603_1608Metric; MPN 0603WAF8201T5E; LCSC C25981
R104: 2.2k; R_0603_1608Metric; MPN 0603WAF2201T5E; LCSC C4190
R105: 1M; R_0603_1608Metric; MPN 0603WAF1004T5E; LCSC C22935
R106: 120k; R_0603_1608Metric; MPN 0603WAF1203T5E; LCSC C25808
R107: 33k 1%; R_0603_1608Metric; MPN 0603WAF3302T5E; LCSC C4216
R108: 150k; R_0603_1608Metric; MPN 0603WAF1503T5E; LCSC C22807
R109: 340k 1%; R_0603_1608Metric; MPN FRC0603F3403TS; LCSC C2933203
R110: 100k 1%; R_0603_1608Metric; MPN 0603WAF1003T5E; LCSC C25803
U101: LM5164DDAR; HSOP-8-1EP_3.9x4.9mm_P1.27mm_EP2.41x3.1mm; MPN LM5164DDAR; LCSC C477928
U102: AP2112K-3.3; SOT-23-5; MPN AP2112K-3.3TRG1; LCSC C51118

Connections:
+3V3: C114.1, C115.1, R104.1, U102.5 (VOUT); also elsewhere on the board
/Power/BUCK_FB: C110.2, R109.2, R110.1, U101.5 (FB)
unnamed: C109.1, C110.1, R108.2
unnamed: D101.2 (A), Q101.1 (G), R101.1
unnamed: D104.2 (A), R104.2
unnamed: C109.2, C111.1, C112.1, D105.2 (A), L101.2, R109.1
unnamed: F101.1, J101.2
unnamed: F101.2, Q101.2 (D)
unnamed: C108.1, U101.7 (BST)
unnamed: R105.2, R106.1, U101.3 (EN/UVLO)
unnamed: R107.1, U101.4 (RON)
unnamed: C108.2, L101.1, R108.1, U101.8 (SW)
VBUS: D103.2 (A); also elsewhere on the board
VIN_SENSE: C104.1, R102.2, R103.1; also elsewhere on the board

Notes on the sheet:
reverse polarity: body diode conducts, then Q101 turns on
36 V -> 2.73 V at the ADC
5.28 V set (340k/100k); BST cap is 2.2 nF, not 100 nF
USB alone runs the logic (~4.6 V); firmware will not fire below 15 V VIN

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
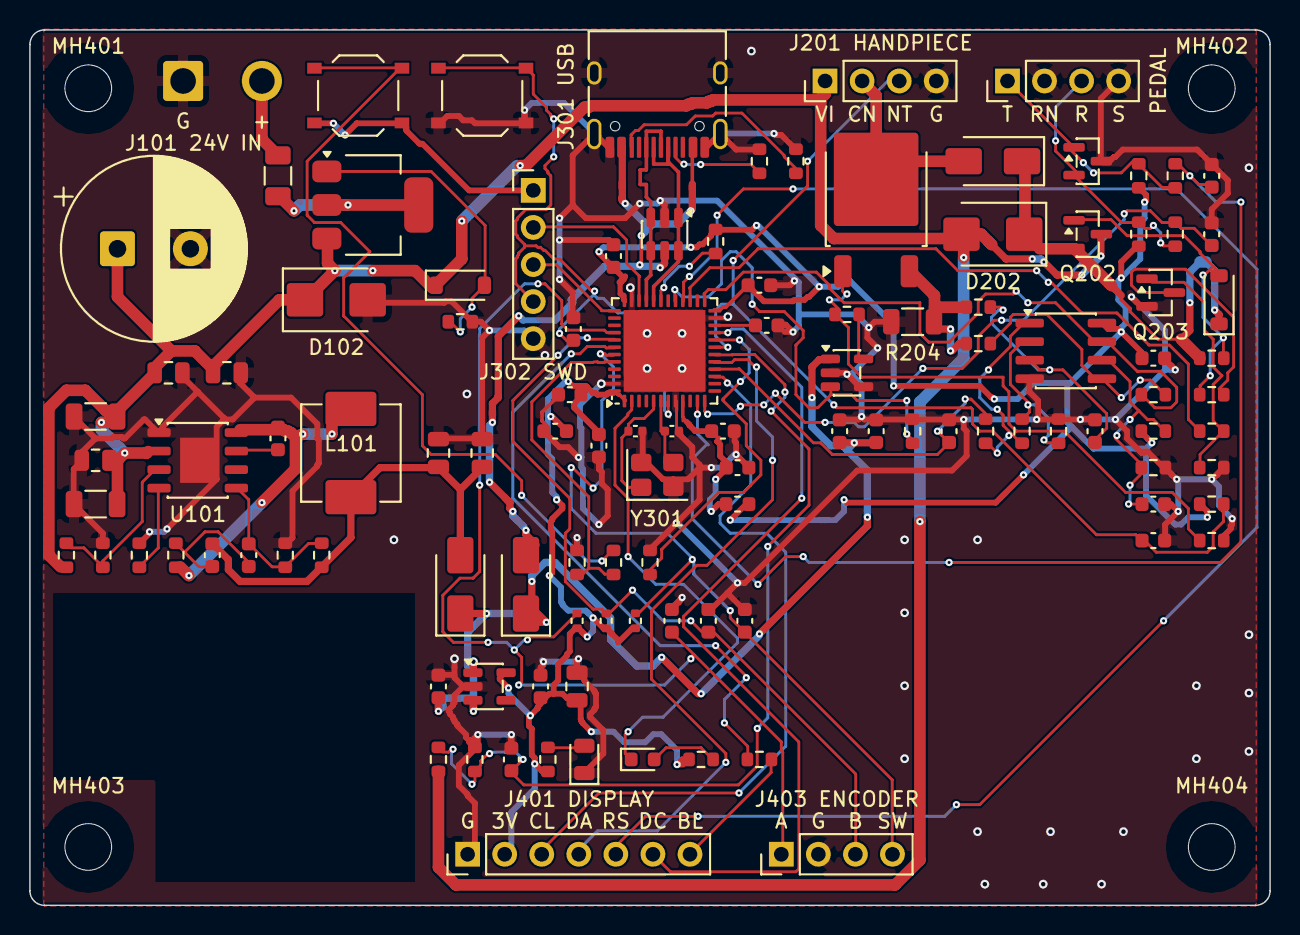
[picture p17: board graver-controller.kicad_pcb from above]

Board: 4 copper layers, 85.0 x 60.0 mm, 117 parts (0 on the bottom side), 65 nets.
