delandtj/stm32-engraver/(commit log)

2026-09-13 docs: ADR 0001 graver controller board spec
    STM32F411 on-board controller for a class batch of 8-10 units: 24 V
    system for the 141 ohm 1335 coil, TIM1 hardware-timed strikes with
    current sense and BKIN overcurrent trip, selectable fast/slow decay,
    1.3in ST7789 display, single EC11 encoder, TRS expression pedal, GX12
    handpiece connector, zero-solder fab assembly.
2026-09-13 hardware: KiCad project skeleton for graver controller, ADR 0001 accepted
    Hierarchical schematic with Power, Driver, MCU and IO sheets under
    Hardware/graver-controller/. ADR 0001 review asks all answered yes.
    [driver.kicad_sch, graver-controller.kicad_pcb, graver-controller.kicad_sch, mcu.kicad_sch, power.kicad_sch]
2026-09-13 hardware: capture graver controller schematic rev 0.1
    Power (LM5164 buck, reverse-polarity P-FET, SS14 ORing, AP2112K),
    Driver (UCC27517 + IRLR3410 low side, SS110 + SMBJ24A fast-decay
    clamp with SI2309 bypass, 1 ohm shunt, TLV9062 amp and overcurrent
    comparator to TIM1_BKIN, GX12 handpiece terminal), MCU (STM32F411CEU6,
    25 MHz, USB-C DFU, SWD) and IO (1.3in ST7789 header, EC11E encoder,
    NMJ6HCD2 pedal jack). All parts carry LCSC numbers. ERC clean except
    one BSS123 library-copy warning.
    ADR 0001 folds in the part selection results and deviations: LM5164,
    two-Schottky 5 V ORing, BSS123 level shifter, coils >= ~100 ohm,
    EC11E15244G1 (30/15), ring-normal plug detect, 1x7 display header,
    direc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
    [driver.kicad_sch, io.kicad_sch, mcu.kicad_sch, power.kicad_sch]
2026-09-13 hardware: keep part-selection notes, KiCad 10 re-save of schematic
    docs/parts-power.md and docs/parts-mcu.md record why each part was
    chosen, LCSC numbers, the LM5164 reference values and the datasheet
    gotchas still to verify (NMJ6HCD2 contacts, DC jack pin 1, terminal
    drill). docs/capture-netlist.md is the sheet-by-sheet netlist the
    schematic was captured from.
    The .kicad_sch/.kicad_pro changes are eeschema's re-save only: an XML
    netlist export shows identical components, values, footprints, LCSC
    fields and nets (117 parts, 83 nets) before and after. Ignore KiCad
    10's .history/ local-history folder.
    [driver.kicad_sch, graver-controller.kicad_sch, io.kicad_sch, mcu.kicad_sch, power.kicad_sch]
2026-09-14 hardware: redraw the four schematic sheets with real wiring
    The captured sheets connected everything by name with parts scattered on
    the page. The sheets are now generated from hand-designed layouts
    (Hardware/graver-controller/tools): decoupling caps drawn at their pins,
    signal flow left to right, wires inside each block, global labels only
    where a net crosses sheets. Power is two rows, MCU and IO fit A4.
    Circuit unchanged: verify.sh compares the XML netlist against the
    captured sheets kept in tools/ref (117 components with values,
    footprints and LCSC fields, 65 nets by pin set) - identical. ERC: 0
    violations. Q203 uses the generic Q_NMOS_GSD symbol (value BSS123),
    which removes the library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
    [driver.kicad_sch, graver-controller.kicad_sch, io.kicad_sch, mcu.kicad_sch, power.kicad_sch]
2026-09-16 firmware: embassy-stm32 bring-up for the Blackpill, ADR 0002, bench rig wiring
    Rust firmware crate for the STM32F411 (Blackpill now, production board
    later, same pin map): TIM1 one-pulse strike engine with break latch, ADC
    sweep, encoder or three-button input, mode F/S control model with menu,
    ST7789 UI, flash settings journal, IWDG, ROM DFU entry on held push.
    Builds clean for the default, buttons and bench features; not yet run on
    hardware. docs/bench-rig.md describes the breadboard rig on the dual lab
    supply.
2026-09-16 docs: handpiece cable spec and colour code in ADR 0001
2026-09-16 hardware: KiCad re-save of the four sheets and project file
    Whitespace and line-wrapping only in the sheets (kicad-cli / eeschema
    formatting of the generated output); the project file gains KiCad's
    default board design settings from opening the PCB editor. No circuit
    change.
    [driver.kicad_sch, io.kicad_sch, mcu.kicad_sch, power.kicad_sch]
2026-09-16 docs: buttons stand-in for the encoder in the bench rig
2026-09-16 firmware: log raw button pin levels at debug level
    On change and every 2 s, so a bench wiring problem shows up in the
    defmt stream without a scope. First hardware run: display, buttons,
    menu and the flash settings journal verified on the Blackpill.
    [input.rs]
2026-09-16 firmware: reject an unsteady NTC reading as no thermistor
    A floating NTC pin on the bench rig wandered around 40 C. A real NTC
    behind the 10k pull-up and 100 nF is DC-steady, so a raw spread over
    80 mV in 200 ms now means no NTC, on top of the open/short thresholds.
    Verified on the Blackpill: the field shows -- with PB1 unconnected.
    [analog.rs]
2026-09-16 firmware: low-vin feature, fire from 10 V on the 12 V bench rig
    Also the EG27324/M3004D module pinout and a bring-up sequence in the
    bench doc, after a miswired module took out the Blackpill and the
    ST-Link.
2026-09-16 firmware: larger screen fonts for microscope users
    Rate and strength in ProFont 24 pt (16x30), the secondary readings,
    status bar and menu in 18 pt (12x22), labels in bold 9x18. Chosen by
    Jan on the real 1.3 inch panel: operators switch from a microscope or
    wear reading glasses. Calibration rows renamed Heel cal / Toe cal to
    fit the wider font.
2026-09-17 firmware: calmer screen updates
    Pedal travel is sticky below 0.8 % of travel so ADC noise stops
    twitching rate, strength and the strikes; the screen holds supply,
    on-time and temperature until they move past the noise; cells repaint
    in one pass with the text's own background instead of a black wipe.
    [analog.rs, ui.rs]
2026-09-17 docs: wiring picture for the MOSFET module on the bench rig
2026-09-17 docs: photo of the EG27324/M3004D MOSFET module used on the bench
2026-09-17 docs: ADR 0003, PCB layout and board production (Proposed)
2026-09-17 docs: ADR 0003 accepted, review asks answered
    Cover plate over a hidden PCB, board 110 x 70 mm with the pedal jack at
    the far right of the rear edge, bulk cap upright under a dome in the
    cover, loose THT connectors ordered before layout. The display module
    moves into the cover plate on a 7-way ribbon to a keyed 7-pin header.
2026-09-17 docs: LCSC numbers for the loose parts order, J3 is a JST XH header
    B7B-XH-A (C144398) with XHP-7 and SXH-001T-P0.6 on the cable side; XH
    pitch is 2.50 mm, so J3 takes the JST footprint. Order list with what to
    measure on each part in parts-mcu.md 14a.
2026-09-17 hardware: retire the schematic generator, J401 becomes a JST XH header
    eeschema is the source of truth from here (ADR 0003). build.py refuses to
    overwrite the sheets without --force-overwrite, verify.sh keeps ERC and
    the renders and now fails on ERC violations. J401 (display): B7B-XH-A,
    C144398, 2.50 mm pitch footprint; nets and pin order unchanged, ERC 0.
    [io.kicad_sch]
2026-09-18 docs: ADR 0003 design rules amended after the autorouter trial
    Board minimums 0.2 mm track / 0.15 mm clearance so the 0.5 mm pitch QFN48
    and USB-C can be escaped; USB is a coupled full-speed pair, not 90 ohm.
    Layout method: scripted placement and locked critical copper, the
    KiCadRoutingTools router for the rest, graded only with kicad-cli DRC.
    Block drawing redrawn with the rear edge at the top, as KiCad shows it.
2026-09-18 hardware: design rules and net classes in the project, U101 without library thermal vias
    Board minimums 0.2 mm track, 0.15 mm clearance, 0.6/0.3 mm via, 0.3 mm
    copper to edge; net classes Default 0.2, Power 0.5 (+3V3, +5V, VBUS,
    VDDA), HighCurrent 0.8 / 0.4 mm clearance (VIN, COIL_NEG, CLAMP,
    SHUNT_HI). The HSOP-8 ThermalVias footprint carries 0.2 mm drills, below
    the board minimum; the EP vias get added by the copper script instead.
    [power.kicad_sch]
2026-09-18 hardware: scripted placement, board generated from the netlist
    tools/pcb/place.py builds graver-controller.kicad_pcb from the kicadxml
    netlist (117 parts, footprints linked to their symbols by UUID, 0
    schematic parity issues), draws the 110 x 70 mm outline and places every
    block per ADR 0003 with placement as data. It checks courtyards, M3
    keepouts and the ADR distance criteria and prints a PASS/FAIL table;
    render.sh makes the review PNGs; routability.sh autoroutes a scratch copy
    at the committed rules as a placement test. No copper yet.
    [graver-controller.kicad_pcb]
2026-09-18 hardware: copper script, first pass of the locked critical copper
    tools/pcb/copper.py (place.py --copper): B.Cu ground pour, M3 and crystal
    keepouts, QFN fanout with EP vias, decoupling links, crystal legs and
    guard, VDDA chain, USB pair (39.8 / 39.0 mm, skew 0.8 mm, no vias),
    VIN and flyback loop at 1.0 mm, buck loops, +5V / +3V3 links; all locked
    and grouped. Repo board: 0 DRC errors, 0 parity, 107 pad pairs left for
    the router. Known: NRST and the pedal inputs are trapped behind the
    crystal island, R209/R213 are not at the shunt, 12 short local traces
    not drawn; see README.
    [graver-controller.kicad_pcb]
2026-09-18 hardware: copper pass 2, crystal in the corner, Kelvin taps at the shunt
    Crystal island moved in front of pads 1-5 (PC13-15 unused): OSC legs
    3.2 / 4.8 mm, pads 7-12 now escape freely, NRST cap 2.1 mm and VDDA 1 uF
    2.5 mm from their pins. R209/R213 within 1.2 mm of the shunt pad edges,
    Kelvin traces from the pad edges. Sense-side ground checked as a tree
    with one tie at R204's ground pad, 5/5 pass. USB pair 37.9 / 37.9 mm,
    skew 0. Repo board 0 DRC errors, 0 parity, 101 pad pairs left for the
    router (was 107); strict routability test 6 open nets, 120 vias.
    Known: VBAT decap 2.9 mm (advisory), R213 -> U202.5 and the buck
    EN/UVLO divider left to the router, 12 local traces listed in README.
    [graver-controller.kicad_pcb]
2026-09-18 hardware: scripted silkscreen
    tools/pcb/silk.py (place.py --copper --silk): references at 1.0 mm /
    0.15 mm placed by search next to their part, off pads and off each
    other (10 inside the body, 87 within 1.5 mm, 7 within 3 mm, 9 in
    reference rows); rear-edge labels DC 24V, USB, SWD, HANDPIECE with the
    pins in board order (4 GND 3 NTC 2 COIL 1 VIN), PEDAL; J401 pin names;
    pin-1 marks on J201, J302, J401; title. Library silk of the four rear
    connectors clipped to the outline (4 lib_footprint_mismatch warnings,
    deliberate). silk_overlap / silk_over_copper / silk_edge_clearance
    92 / 92 / 17 -> 0. Copper unchanged (234 tracks, 78 vias, 6 zones),
    0 DRC errors, 0 parity, 101 pad pairs left for the r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
    [graver-controller.kicad_pcb]
2026-09-18 hardware: autoroute stage for the remaining nets, first mostly routed board
    tools/pcb/autoroute.py (place.py --route): copies the board to scratch,
    runs KiCadRoutingTools with escalation off and strict sizes, grades the
    copy with kicad-cli against the committed .kicad_pro and imports only
    complete, error-free nets, grouped 'autorouted' so the stage can redo
    them; zones refilled in pcbnew afterwards. copper.py reserves bands
    along the USB pair on B.Cu after the router cut its ground reference
    11 times. Scripted copper unchanged (234 tracks, 78 vias, flyback
    20.3 mm, USB 37.88/37.88, Kelvin 1.15/1.23, sense ground 5/5).
    Repo board: 0 DRC errors, 0 parity, 20 unconnected pad pairs in this
    rege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
    [graver-controller.kicad_pcb]
2026-09-18 hardware: QFN escape fan, scripted 3V3 trunk and CLAMP tap, 6 pad pairs left
    copper.py: QFN pads 15-21 and 40-44 escape as a 45-degree fan into a
    second ring with the vias at 2.9 mm, so no pad is boxed in any more;
    USBLC6 die-duplicate pins bridged (1+6, 3+4); encoder MP lugs linked;
    +3V3 as a scripted tree (240 mm, 0 vias; the MST floor over its 29 pads
    is 183 mm, the ADR's 120 mm budget is not reachable with this placement);
    +5V 33 mm, no via; CLAMP D202 -> Q202 tap 12.7 mm instead of the
    router's 50 mm. autoroute.py runs the router three times and imports
    the best (fewest errors, open, vias); summary in output/pcb.
    Repo board: 0 DRC errors, 0 parity, 6 unconnected pad pairs
    (VIN_SENSE x3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
    [graver-controller.kicad_pcb]
2026-09-18 hardware: GATE_IN, VCAP1 and VIN_SENSE drawn explicitly, 4 pad pairs left
    copper.py: SIGNAL_EXPLICIT table drawn before the rails so the strike
    signal (GATE_IN 16.7 mm), VCAP1 (10.8 mm) and the VIN_SENSE divider and
    filter (20.2 mm, no via) get their lanes first. place.py: 3D model
    substitutes for the QFN (EP 5.15 variant) and the two tact switches;
    J301, SW401 and J402 have no library model anywhere and need
    manufacturer STEP files before the enclosure export (README).
    Repo board: 0 DRC errors, 0 parity, 4 unconnected pad pairs (I_SENSE x2,
    DECAY_SLOW, LED_STAT), 202 vias. Budgets unchanged: USB 37.88/37.88
    skew 0, flyback 21.4 mm, buck CIN 2.9/2.7 mm, Kelvin 1.15/1.23, sense
    ground 5/5, n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
    [graver-controller.kicad_pcb]
2026-09-18 hardware: scripted GND stitching, I_SENSE explicit, manual-track preservation
    copper.py: every top-side GND pad (58) gets its own stub and via into
    the pour, 17 edge stitching vias, a GND spine joining the F.Cu pieces;
    the router no longer routes GND. Two real bugs fixed on the way: pad
    numbers are not unique (SW302 has two pads '2', one was stitched twice
    and one never) and the crystal's ground pads were tied to each other
    and to nothing else. I_SENSE drawn explicitly (7.7 mm, no via).
    manual.py + place.py --export-manual keep tracks drawn by hand in
    pcbnew across regeneration (round trip verified, manual.json absent).
    Repo board: 0 DRC errors, 0 parity, 5 unconnected pad pairs (GND x2
    pou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
    [graver-controller.kicad_pcb]
2026-09-18 docs: handoff for the routed board
2026-09-18 hardware: DRC rules for the power net widths
    KiCad treats net class widths as defaults, not limits, so the board
    passed DRC with 97 mm of VIN, 57 mm of +3V3 and 50 mm of VBUS drawn by
    the autorouter at 0.2 mm. graver-controller.kicad_dru now requires
    0.5 mm on HighCurrent and 0.3 mm on Power tracks (necking at small
    pads allowed). DRC on ed2437c with these rules: 199 track_width
    errors, all in the autorouted group (VIN 55, +3V3 79, VBUS 35 and the
    rest), 0 otherwise. The route stage passed --power-nets-widths to the
    router and the router did not honour them; to be fixed in autoroute.py
    or by hand.
2026-09-18 hardware: power widths honoured, GND closed, 3 pad pairs left
    Two causes of the 0.2 mm power runs: the router necks a blocked wide
    route down to --track-width and never widens it back, and the
    .kicad_dru was never copied next to the scratch boards, so neither the
    router nor the import gate saw the width rules (the real count was 237,
    kicad-cli caps its report at 199). autoroute.py now routes one pass per
    width floor (0.5, 0.3, then 0.2 mm signals), reads the floors from the
    .kicad_dru and copies .kicad_pro + .kicad_dru beside every scratch
    board; copper.py widths raised to the floors and checked.
    Repo board with the width rules: 0 DRC errors, 0 parity, 3 unconnected
    pad pairs (VDDA 2 mm, PB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
    [graver-controller.kicad_pcb]
2026-09-18 hardware: VDDA and PB2 closed by script, board file kept at the 3-open routing
    copper.py: VDDA pin 9 -> C306 as a layered path (2.95 mm, two vias, all
    0.30 mm; no top-layer lane exists at any width without moving C309 by
    0.8 mm), PB2 via -> R303 layered (6.7 mm), escapes off C202 and C309 so
    those pads are no longer boxed in. The +5V C201 <-> D105 crossing has
    no corridor that does not run under the USB pair or 95-112 mm around
    the board edge; it stays open for a hand route or a placement change.
    The route run on this copper came out worse (10 open, 2 on GND: the
    mop-up re-lays 0.3 mm nets at 0.2 mm and the size gate drops them),
    so graver-controller.kicad_pcb is unchanged from db1ba76 (0 e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
2026-09-18 docs: handoff for the 3-open board and the route-stage caveats
2026-09-19 hardware: last three connections drawn by hand, board fully connected
    tools/pcb/close_pairs.py draws them into the committed board as the
    'manual' group and manual.json keeps them across regeneration:
    VDDA pin 9 -> C306 (3.4 mm, 0.30 mm, 2 vias), PB2 via -> R303 (6.3 mm,
    0.20 mm, 1 via), +5V U102/D105 -> C201 (63 mm, 0.30 mm, 10 vias) with
    one 1.6 mm crossing under the USB pair at 90 degrees on B.Cu, 0.6 mm
    from the pair, whitelisted in the USB reference check. To make room:
    +3V3's B.Cu trunk doglegged 0.4 mm, PEDAL_RING's dead stub shortened,
    ENC_A re-routed on B.Cu (7 -> 18 mm, 2 more vias). manual.py bug fixed
    (the manual group was listed as scripted, so export collected nothing).
    kicad-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
    [graver-controller.kicad_pcb]
2026-09-19 docs: handoff, board fully connected
2026-10-01 hardware: wire pads instead of connectors, board to 95 x 70
    ADR 0003 Decision 9. Every board connector except USB-C becomes a row of
    plated through-holes and the rotary encoder moves off the board onto wires;
    Jan solders the looms at box build. The mating halves were the sourcing
    problem, not the board halves, and the four connectors dropped here were
    also the four parts whose footprints were still unverified against real
    hardware.
    Schematic (ERC 0, netlist diffed pad-by-pad - every difference was an
    auto-generated net NAME following its anchor pin, no connectivity changed):
    - J101 Barrel_Jack_Switch -> Conn_01x02, SolderWire-1sqmm 1x02, 1.4 mm
    - J201 -> PinHeader_1x04, J401 -> PinHeader_1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
    [driver.kicad_sch, graver-controller.kicad_pcb, io.kicad_sch, power.kicad_sch]
2026-10-01 docs: correct the SWD pinout and two overstatements about USB-C
    The SWD pin order in parts-mcu.md section 5 was wrong. It read
    1 3V3 / 2 SWCLK / 3 GND / 4 SWDIO / 5 NRST; the schematic has
    1 +3V3 / 2 SWDIO / 3 SWCLK / 4 NRST / 5 GND. It swapped clock and data
    and put ground on the wrong pin, which would have cost someone an
    ST-LINK cable built from the doc instead of from the board. The line
    called itself a suggestion from before capture; it is now the as-drawn
    pinout, labelled as such. Its stale rationale about needing THT assembly
    for the encoder, jacks, socket and terminal is also removed - none of
    those parts exist since ADR 0003 Decision 9.
    Two claims made on 2026-10-01 were too strong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
2026-10-01 docs: brick sizing and the 12 V analysis in the handoff
    Sizing: buy 24 V 2 A. The box needs ~290 mA worst case (170 mA coil while
    the FET is on, plus up to ~115 mA for the logic through the buck) and about
    95 mA average at the 35 % duty cap - roughly 7 W. 1 A would do it with 3x
    margin; 2 A costs the same and buys inrush headroom into the 470 uF cap,
    room for a low-resistance coil, and most importantly no sag during the
    strike. Droop weakens the hit directly, and the firmware warns below 18 V
    and refuses below 15 V, so a weedy brick both softens strikes and nags. The
    470 uF buffers the fast edge only: at 170 mA for 15 ms it would sag 5.4 V
    alone, so stiffness matters more than raw amps. Ceil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
2026-10-01 hardware: board electrically complete, last 3 pairs closed by hand
    0 DRC errors, 0 schematic parity, 0 unconnected, 11 warnings. All eight
    per-net width floors PASS, GND islands and the sense-ground tree PASS, one
    allowed USB crossing and no disallowed ones.
    The autorouter left three pairs open: +5V D105.1 -> C201.1 (the ORing
    Schottky to the gate driver's supply cap - without it the driver sits in
    UVLO and the board never fires) and two short GND stubs. Closed with a new
    tools/pcb/close_open.py, then captured into manual.json with
    place.py --export-manual: 38 items, 33 on +5V and 5 on GND.
    close_open.py is a thin driver over the GOOD half of close_pairs.py - the
    two-layer clearance grid,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
    [graver-controller.kicad_pcb]
2026-10-01 docs: J101 is a 1.75 mm drill, not 1.4, plus the drill table
    The footprint is named SolderWire-1sqmm_1x02_P5.4mm_D1.4mm_OD2.7mm and the
    D1.4mm reads as a drill size. It is not one - the file says (drill 1.75),
    and the D figure is the wire the pad suits. The ADR 0003 Decision 9 table,
    parts-mcu.md and the handoff all repeated the misreading since the rework
    went in.
    Nothing on the board changes. 1.75 mm is roomier for an 18 AWG brick lead
    than 1.4 would have been and the annular ring is still 0.48 mm, so this is
    a documentation fix only - but three documents stating a hole size that the
    Gerbers disagree with is exactly the kind of thing that gets noticed at the
    fab instead of here.
    Also rec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
2026-10-01 docs: handoff rewritten to open on the finished board
    The banner still said the route was in flight and the next-steps list still
    opened with "finish the route", both left over from this morning. Replaced
    with a "Start here" that a cold session can act on:
    - the board is finished and tagged v0.2, 0 errors / 0 parity / 0 unconnected
    - it has never been near hardware, and that distinction is stated plainly
    rather than buried: "0 DRC errors" is not "it works", which this document
    already managed to imply once today
    - the single next piece of work is the export set (ADR 0003 step 8), which
    does not exist
    - three decisions are blocking, named up front
    Next steps renumbered now that the co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
2026-10-08 firmware: bench burst feeds the heartbeat while it waits
    The burst runs in the control task before its loop, so the 3 s arm delay
    starved the watchdog supervisor and the chip reset at ~1 s, before any
    pulse. Sleep in 100 ms slices and beat in between.
    [bench.rs]
2026-10-08 firmware: strike path never fired - lost commands and a stuck break
    Two bugs, either one alone kept PA8 low:
    - The idle wait in strike_task selected on rx.changed() and dropped the
    result. changed() marks the value seen, so try_changed() at the loop
    top never saw it and firing=true was lost. Keep the value.
    - BDTR was set through a chain of embassy modify() helpers. On the F4 a
    BDTR write takes one APB cycle to land, so the next read-modify-write
    read stale bits and wrote BKP back to 0. The break input became active
    low and the PB12 pull-down latched it on the first pulse (OVERCURRENT
    on screen). Write BDTR once with all fields; it now reads 0x3400.
    [strike.rs]
2026-10-09 docs: bench rig 24 V warning, two FET modules killed by it
2026-10-09 docs: bench rig - PSU off before SWD, IBT-2 wiring for 24 V
2026-10-09 docs: ADR 0004 settable boost coil rail (VIN..40 V) with NTC-guarded overdrive
2026-10-09 firmware: duty cap settable up to 100 %, default stays 35 %
    Heat above 35 % is the operator's call, guarded by the NTC limit.
    T_ON_MAX_US still bounds each pulse. ADR 0002/0004 updated.
2026-10-09 docs: ADR 0005 compact 4-layer board with pcbkit, granite_controller style
2026-10-09 pcb: ADR 0005 stage 1 - 4-layer board, rules, placement with pcbkit
    New board from the netlist with pcbkit mkboard: 85 x 60 mm (the ADR 0005
    ceiling), JLC04161H-7628 stackup, In1 = GND plane, In2 = +3V3 plane. Net
    classes and board rules per ADR 0005 Decision 3 in the .kicad_pro, width
    floors in the .kicad_dru, all of it driven from pcbkit.toml.
    tools/pcb5/place.py places all 117 parts in bands (power left, MCU centre,
    driver right, pad rows on the rear and front edges), adds the M3 and crystal
    keepouts, an L-shaped 25 x 20 mm ADR 0004 boost reserve at the front left,
    the inner plane zones and the QFN EP vias, and prints the ADR 0003 distance
    checks (all PASS). USB-C mouth flush with the re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
2026-10-09 pcb: ADR 0005 stage 2 - scripted USB pair and crystal, router settings
    tools/pcb5/handroute.py draws the USB pair J301 -> USBLC6 -> MCU on F.Cu at
    0.25/0.15 with no vias: pad stubs above (D+) and below (D-) the connector
    row so neither crosses the other, an orthogonal detour sized from the two
    leg lengths so the skew is 0.000 mm, and the crystal's OSC tracks through
    the load caps. The copper sits in group 'hand', which krt-route now keeps.
    Router clearance 0.15 (the Default class), USB class clearance 0.15, the
    crystal keepout now blocks B.Cu tracks only so the crystal's own tracks and
    its GND vias are allowed. check.py reads the ADR distances pad edge to pad
    edge and parses the kicad-cli p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
2026-10-09 pcb: ADR 0005 stage 3 (WIP) - routed board, pours, silk, labels; 31 opens
    KRT routed everything except 10 single-pin nets on the QFN's left and
    bottom sides (DECAY_SLOW, ENC_B, LCD_BL/DC/MOSI/RST, LED_STAT, NRST, PB2,
    VIN_SENSE); the USB pair and crystal hand routes survived the run. DRC on
    this board: 0 parity, 31 unconnected, 151 errors (93 track_width necks
    below the .kicad_dru floors, 27 stitching vias inside the boost reserve
    from a gndpour bug now fixed in pcbkit, 31 opens). Not finished: see the
    ADR 'As built' section and the session handoff.
2026-10-09 pcb: ADR 0005 accepted - 4-layer board routed, DRC 0/0/0, fab set
    kicad-cli DRC after a zone refill: 0 errors, 0 unconnected, 0 schematic
    parity, 11 warnings (10 silk_overlap, 1 track_dangling). 85.0 x 60.0 mm.
    USB pair 0.25/0.15 with 0.000 mm skew, 0 vias, F.Cu only. Two via sizes,
    five track widths, In1/In2 track-free solid planes, every ADR 0003
    placement rule met (tools/pcb5/check.py: 0 FAIL).
    What it took beyond stage 2: a staggered stub-and-via escape for every
    used QFN pin (handroute.py qfn_fan), KRT run with net class clearances and
    the hand routes kept, widths snapped to the ADR set (widen.py), plane-tap
    vias removed from SMD pads (postroute.py), and explicit joins for the five
    pai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
2026-10-09 pcb: ADR 0005 - no DRC warnings left
    The ten silk_overlap warnings were J302's five pin legends stacked on one
    point by connlabels (vertical header inside the board): no legends there.
    The track_dangling warning was pin 25's fan stub after its unused via was
    pruned: pruned. Renders and fab set regenerated from the final board.
2026-10-09 docs: ADR 0005 - width floors and open question 2 flagged as Jan's decisions
    HighCurrent nets meet ADR 0003's 0.5 mm floor; 52 short +3V3/VBUS/VDDA
    necks (46 mm) sit at 0.2-0.25 mm against the old 0.3 Power floor, and only
    10 of them can be widened to 0.3 (the rest hit clearance). The .kicad_dru
    floor is half the class width; the ADR says so and leaves the choice to
    Jan. ERC re-run on the final schematic: 0 violations.
2026-10-09 pcb: ADR 0003 width floors restored and met; DRC 0/0/0 with 0 warnings
    The 52 power necks were the router bending +3V3/VBUS/VDDA around signals
    it had laid first, and most of what blocked widening them was the stale
    GND pour (widen.py now refills before judging). tools/pcb5/floors.py rips
    the five signal nets in the way (LCD_SCK, ENC_SW, LCD_BL, LCD_RST, the
    op-amp feedback, PEDAL_TIP east of the MCU), re-draws the R404 stub and
    the VDDA run, widens the rest to class width, and adds the 'fine-pitch'
    rule areas; krt-reroute --keep re-lays the signals around the wider
    copper.
    .kicad_dru is back at ADR 0003's floors: 0.5 mm HighCurrent, 0.3 mm 5V and
    3V3 classes, with 0.2 mm only inside the fi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
2026-10-09 fab: CPL rotations verified against the EasyEDA footprints, six corrected
    tools/pcb5/cplcheck.py fetches the EasyEDA footprint behind every LCSC
    number, fits the KiCad footprint's pads onto it (by unique pad number, by
    geometry where KiCad repeats numbers) and compares the implied KiCad -> JLC
    correction with the CPL; the sign is calibrated on the two parts granite
    confirmed in JLC's preview. 27 of 27 orientation-sensitive parts agree
    after fixing the package-convention guesses: D104 and D301 (LEDs, EasyEDA
    pad 1 is the anode: 180), Q201 IRLR3410 (90), U102 AP2112K (270 while the
    other SOT-23-5 is 180), J302 header (270), L101 (180).
2026-10-12 graver pcb: KRT from ~/Electronics/krt (pcbkit default), no longer under ~/.cache
2026-10-13 docs: HANDOFF - pedal decided, 5-pin TIG foot pedal on J402, no board change
2026-10-16 docs: bring-up checklist - per-board tests, per-box loom checks, first-board questions
2026-10-18 graver pcb: F101 -> 1206L035/30WR PTC; the 0437001.WR is a fast fuse and blows on hot-plug inrush
    Board 1 blew F101 on the first 24 V connect. The 437 series is fast-acting
    (1 A, I2t 0.100 A2s), not Slo-Blo as the parts doc said; hot-plugging 24 V
    into C101 470 uF is roughly 0.27-0.45 A2s. A 1206 PTC (0.35 A hold, 30 V,
    Imax 100 A) ignores the inrush pulse and resets after a fault. Same footprint,
    so the 12 built boards take it as a one-part swap. fab/ is left as built.
2026-10-19 box: ADR 0006 enclosure - printed wedge, tray plus cover, slide-in display
    FreeCAD model driven by a Params sheet (Box/enclosure.FCStd), rebuilt and
    exported by Box/build_enclosure.py. Pedal GX16-5 at the rear, handpiece
    GX12-4 at the front, display and encoder side by side on a 15 deg top.
    Cover screws in from below, display held by rails and two printed snap
    tongues, cable strain relief post behind the rear-wall entry. Display
    thickness, encoder bushing, USB-C height and cable diameter are still
    placeholders.
2026-10-19 box: display holder to the vendor drawing, measured 3.1 mm module
    PCB 27.5 x 39 x 1.2, backlight 26.16 x 29.22, active area 23.4 square
    6.22 mm from the header edge, so the window moves 6.6 mm toward the header
    end and the encoder follows. Rail lip 1.7 mm, latch clear of the header
    pin tails, FPC relief at the far end.
2026-10-19 box: rim screw bosses, support-free at 60 deg
    Full-height cover columns become 10 mm bosses at the rim with 65 deg
    gussets. Rail lip undersides and the window chamfer at 60 deg, GX12/GX16
    holes teardropped under the nut, tray counterbores bridged with a 0.3 mm
    sacrificial layer. Only bridges remain flatter than 60 deg.
2026-10-19 box: encoder two-nut mount, 7.8 mm bushing
    Hole 8.1 mm, 2.0 mm panel between two nuts, anti-rotation slot dropped,
    14.7 mm clear circle under the panel for the inner nut.
2026-10-19 box: encoder nut measured, 10 mm AF x 2 mm
2026-10-19 box: pedal socket GX12-3 at the rear, USB-C height and cable confirmed
    Both sockets are GX12 now; the pin count keys them apart (handpiece 4,
    pedal 3, never 4). HANDOFF and the loose-parts list follow.
2026-10-19 graver pcb: thermal relief on the In1 GND and In2 +3V3 planes
    The inner planes connected THT pads solidly (KRT default), so the GND pads
    of J401/J403/J201/J402/J101/J302 would not take solder from a hand iron on
    the first batch. Zones refilled with spokes; DRC 0, parity 0, 0 unconnected.
    pcbkit now passes --thermal-relief to KRT (pcbkit eca1e47).
2026-10-19 power sch: U103 TPS26602 eFuse replaces F101/Q101/D101/R101 (ADR 0007)
    IN = J101 +24V with C117 100nF 100V and R111 100k to SHDN; OUT = VIN.
    UVLO/OVP/MODE, ILIM (R112 12k 1%, basic part, 1.0 A) and dVdT (C116
    220nF, 42 ms) return to the new RTN net. VIN PWR_FLAG moved to the IN
    net (U103 OUT drives VIN). J101 group shifted 20.32 mm left. ERC 0.
2026-10-19 graver pcb: U103 eFuse block in place of F101/Q101/D101/R101 (ADR 0007)
    tools/pcb5/efuse.py places U103 (HTSSOP-16 PowerPAD, 15 thermal vias),
    C117/R111 on the IN side and C116/R112 on the right, draws IN and OUT at
    0.8 mm, the RTN straps, and an RTN island on F.Cu and B.Cu (zones at
    priority 2 above the GND pours) with a rule area keeping the In1 GND and
    In2 +3V3 planes out from under the block; group 'efuse' is kept by
    krt-route. BOOT0 (Net-(R302-Pad2)), which ran through the old block, was
    rerouted with krt-reroute --keep; the +3V3 jumper from J302.1 to SW301.2
    went (both reach the In2 plane). No other part moved.
    DRC after refill: 0 errors, 0 unconnected, 0 parity, 0 warnings (same as
    b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
2026-10-19 graver fab: rev 2 outputs with U103; CPL rotation for the HTSSOP-16 (270)
    cplcheck.py against the EasyEDA footprint of C2872872 wants 270 (fit
    0.10 mm over 16 pads); 26 of 26 parts agree. Stale Q101 SOT-223 entry
    dropped from the corrections.
2026-10-19 docs: rev 2 input eFuse U103 in parts-power.md and HANDOFF (ADR 0007)
    parts-power.md: item 0 (TPS26602PWPR C2872872) with its passives, items
    1/2/2z marked rev 1 only. R112 is 12k 1% Basic (C22790, 1.00 A) instead
    of the ADR's 12.1k, which JLC only has as Extended.
2026-10-19 firmware: 4 encoder counts per detent
    The class encoders rest with A and B open at every detent, a full
    quadrature cycle per click (measured on board 2: -6, -10, -14, -18).
    The Alps 30/15 assumption gave 2 steps per click.
2026-10-19 kicad_pro: ERC rule same_local_global_power added by KiCad
2026-10-19 docs: HANDOFF - display, encoder and settings journal verified on board 2
2026-10-19 firmware: display rotated 180 deg for the box mount
    The module slides into the cover header end down (ADR 0006), so the
    panel's native picture would be upside down. mipidsi 0.10 mirrors the
    offset inside the 240x320 frame buffer itself, so OFFSET_X/Y stay 0.
2026-10-19 docs: HANDOFF - the verified board is board 1 (F101 bridged), not board 2
2026-10-19 docs: HANDOFF - session 2026-10-16..19 summary and new next steps
    Adds the DC-005 power jack and the Frequency-mode strength-vs-frequency
    question (discuss first) to the to-do list; the old next-steps list was
    done or superseded.
